gkostadinov/glimdock/README.md

# Glimdock

Glimdock brings servers, routers, appliances and printers to one small touchscreen. A **host-agnostic Rust collector** owns the node registry, accepts device readings and serves the management web interface. The display pairs with that collector once; registered nodes then appear automatically in its **All systems** bento overview.

Linux, macOS and Windows machines use native Rust agents that push telemetry to the collector. Agents pair once, receive a stable node identity and need no incoming network connection. Routers and other appliances can expose read-only SNMP or a JSON API through the same Rust device agent. Proxmox adds guest, storage and GPU features to a node; Klipper adds print job and temperature views. Neither integration is required to run the collector.

```text
Linux / macOS / Windows agents ──push──┐
SNMP / JSON adapters ────────────push──┤   Moonraker / legacy feeds
                                     │          ↑ polling
                   Rust collector: node registry + web console
                           /                         \
              Glimdock ESP32-S3                Desktop browser
              All systems + details       Overview · Nodes · Display & firmware
```

## Start with the collector

Run the matching Linux or macOS executable with a private state directory:

```sh
glimdock-collector run --state-dir ./glimdock-state --bind 127.0.0.1 --port 8765
```

Open `http://127.0.0.1:8765/`. The same server collects telemetry, applies node edits and serves the interface; no separate web server is needed. Local access works directly. Fresh configurations monitor the collector's native host as an ordinary **Server / device** node. You can pause or remove that node and use the collector only to receive agent pushes and aggregate optional polling feeds.

Use [SETUP.md](SETUP.md) for credentials, LAN access, display pairing and persistent services. [DEVICES.md](public-docs/DEVICES.md) explains how to pair an agent or adapter with a one-time key. Enrollment assigns a stable node ID automatically; changing a name preserves it. Explicit `--re-enroll` renews a revoked publisher with a fresh key while retaining device and node identity. Polling remains available for printers and existing APIs. Devices enroll explicitly; network scanning and credential discovery are not required.

## One interface for the fleet and display

The collector's built-in web console has three views:

| View | What it does |
| --- | --- |
| **Overview** | Live summary cards for every active node, including available CPU, memory, temperature and printer readings |
| **Nodes** | Pair agents; rename, pause, revoke and remove nodes; add polling feeds and manage the optional collector host |
| **Display & firmware** | Run the actual LVGL firmware UI in the browser and update the supported display over USB |

The browser firmware is compiled from the production UI, fonts, parsers and touch behavior into WebAssembly. It shares the display's layout and interactions; browser transport replaces the board peripherals. The larger web overview is a separate interface for managing the fleet.

White/dark themes, a clock view, short notification banners and saved speaker volume make the desk display usable between checks. An optional supported LiPo uses approximate voltage/bands and one warning per confirmed low-voltage episode; it does not report a charge percentage. [Firmware settings](firmware/README.md) document the evidence and limits.

The physical display starts on **All systems**, with up to four summary cards. Tap a card to open its dashboard. Ordinary devices have Overview, Storage, Sensors and Health; Proxmox adds guest views; Klipper has Overview, Job, Temps and Health. Unavailable or expired measurements remain unknown. Up to sixteen remote nodes can be configured, with four active top-level nodes including the optional collector host and eight active nodes in total. Managed switches and other appliances can be grouped beneath a parent node with `parent_id`; each keeps its own readings and freshness.

## Browser firmware updates

Connect a **Waveshare ESP32-S3-Touch-LCD-2.8 V1** Glimdock by USB, open **Display & firmware** in desktop Chrome or Edge, then choose **Connect & update**. Web Serial needs HTTPS or localhost. For a collector served over LAN HTTP, the Rust loopback companion serves the same console on the USB computer; [SETUP.md](SETUP.md) has the command.

The public update verifies the board and image hashes, preserves saved NVS pairing and preferences, and restarts the display. A new board opens setup. The update download includes version-matched source, dependency notices and practical rebuild/relink materials. V2/CST3530 is not supported by the V1 image.

## Private conversation review

Open **Settings → Private conversations** to read authorized user/assistant chats
on the physical display. Pair a separate HTTPS relay over USB using a dedicated,
revocable device credential and CA certificate. Conversations appear as scrolling
chat bubbles with session/message paging and long-message continuation. Private
text stays in a separate transient model and is cleared when you leave the reader.

The public browser demo uses fictional conversations only. Private pairing files,
reader keys and archive contents are excluded from public source and firmware.
See [private-reader setup and API](docs/private-conversations.md).

## Flipper Zero companion screen

An optional Bluetooth LE connection sends compact **System, Alerts, Agents and
Printer** pages to Flipper Zero. Install and open the
[Flipper app](integrations/flipper/README.md), then pair from
**Settings → Flipper Bluetooth screen** on Glimdock. Sharing starts disabled and
requires the PIN shown by Flipper.

The app keeps summaries for up to eight active nodes and previously received
node details in RAM. **Up/Down** changes the displayed node immediately, including
while disconnected; Glimdock fetches the selected node's details in the
background. **Left/Right** switches pages, **OK** returns to System and **Back**
exits. Closing the app clears its cache. Source ages and LIVE, SUMMARY, CACHED,
LOADING, STALE, NO UPDATES, DISCONNECTED and DEMO labels keep freshness visible.

Pairing, six-node browsing, offline navigation, page changes and saved-pair
reconnection have been physically validated on the V1 board with Momentum
mntm-012. See [validation scope](public-docs/VALIDATION.md#flipper-zero-cache--17-october-2026)
for the measurements and tested configuration.

## Hardware and enclosure

The supported board has an ST7789 display, CST328 touch, 16 MiB flash and 8 MiB PSRAM. The current **[Portable r45 enclosure](enclosure/public/portable-r45/README.md)** is a removable sculpted pod with a matching rear shell, battery space, two speakers and separate passive landscape and portrait stands. The native USB opening is on the right in the supported 320 × 240 landscape layout, rotation 3.

The curated public package includes 23 print parts, editable STEP/BREP, an original-parts assembly, an interactive viewer and portable OrcaSlicer layouts. It contains the repaired front/tunnel pair, two carrier rails, compact spring button, closed-front stand and stronger accessories. Printer connections, vendor presets, G-code and development trials are excluded. Physical fit, print finish and battery configuration need their own checks. See [the current enclosure guide](public-docs/ENCLOSURE.md) for source and validation boundaries. The r26 snapshot and r19 parametric model remain historical references.

## Build and contribute

The [agent operations design and API](public-docs/AGENT-OPERATIONS.md) provides a
playable four-tab workspace and a framework-neutral, read-only telemetry
contract. [Integration examples](public-docs/AGENT-INTEGRATION.md) and
[agent-ready implementation prompts](public-docs/AGENT-PROMPTS.md) cover source
adapters, the Rust collector, firmware and release review. It can read shared coordination metadata or another system's JSON
snapshot. The Rust collector and ESP32 consume it in a native four-tab workspace. Use the Nodes / Agents control on the overview to switch workspaces. The original logo returns to the current workspace’s home screen: Agents in Agents mode, Nodes in Nodes mode.

The Rust workspace contains `collector-rs/` and `device-agent-rs/`. Build both executables with:

```sh
cargo build --workspace --locked --release
cargo test --workspace --locked
```

The executables are `target/release/glimdock-collector` and `target/release/glimdock-agent` (`.exe` for a Windows agent). The collector embeds `collector-web/`, the firmware WebAssembly renderer and the public USB update bundle. Build browser assets before compiling a distributable collector; [BUILDING.md](public-docs/BUILDING.md) gives the complete order and verification commands.

| Path | Purpose |
| --- | --- |
| `collector-rs/` | Rust central collector, node configuration and authenticated HTTP APIs |
| `device-agent-rs/` | Native Rust push agents, host telemetry, SNMP and mapped JSON adapters |
| `collector-web/` | Built-in management console, browser firmware and USB updater |
| `firmware/` | Production LVGL touchscreen firmware |
| `examples/` | Generic collector, node, agent and synthetic snapshot examples |
| `deploy/` | Linux service installation and compatibility wrappers |
| `integrations/truenas/` | Optional restricted NAS compatibility helper |
| `tools/native-preview/`, `tools/web-emulator/` | Shared firmware rendering and behavioral verification |
| `enclosure/public/portable-r45/` | Current editable enclosure CAD, print parts, portable layouts and viewer |
| `commercial/site/` | Product website |
| `legacy/python/` | Archived Python collector and former design preview |

Deployed collectors, the web server and device agents use Rust. Python, Node.js, CMake and PlatformIO support builds, rendering and validation; the optional NAS/QGA compatibility probes run on their monitored systems. See [native telemetry](collector-rs/docs/TELEMETRY.md) for measurement semantics and optional tool requirements.

Original software, documentation and graphics are MIT licensed; original enclosure designs use CERN-OHL-P-2.0. Dependencies retain their own licenses. See [LICENSE_POLICY.md](LICENSE_POLICY.md), [THIRD_PARTY_NOTICES.md](THIRD_PARTY_NOTICES.md), [contributing](public-docs/CONTRIBUTING.md) and [security](public-docs/SECURITY.md). Historical validation and prototype observations remain in [docs/validation.md](docs/validation.md).
