gkostadinov/glimdock/public-docs/README.md

# Glimdock documentation

The current introduction and repository map are in [the root README](../README.md).
Start with [SETUP.md](../SETUP.md) to run the central collector, pair native push agents and
pair or update the display.

| Guide | Scope |
| --- | --- |
| [Setup](../SETUP.md) | Linux/macOS collector, built-in console, keys, node management and Chrome USB updates |
| [macOS RAM](../docs/macos-memory.md) | Native pressure, compression, cache, swap and Proxmox guest mapping |
| [Devices](DEVICES.md) | Native push enrollment, Linux/macOS/Windows agents, SNMP routers, JSON APIs and polling migration |
| [Building](BUILDING.md) | Rust workspace, web assets, public firmware and verification |
| [Architecture](../docs/architecture.md) | Registry, runtime boundaries, telemetry and management contracts |
| [Firmware](../firmware/README.md) | Supported board, pairing, orientations and display behavior |
| [Flipper Zero](../integrations/flipper/README.md) | Paired Bluetooth pages, local node cache, buttons, build and installation |
| [Pebble Landscape](../enclosure/pebble-landscape/README.md) | Current enclosure concept and assembly status |
| [Contributing](CONTRIBUTING.md) | Development expectations |
| [Security](SECURITY.md) | Credentials and vulnerability reporting |

Original software and documentation use [MIT](../LICENSE); original enclosure
geometry uses CERN-OHL-P-2.0. [License scope](../LICENSE_POLICY.md) and
[third-party notices](../THIRD_PARTY_NOTICES.md) cover the separate dependencies.
