gkostadinov/glimdock/enclosure/pebble-landscape/README.md

# Historical r19 enclosure source

This folder preserves the earlier parametric model. Current fitted CAD and validation caveats are in [the Pebble public prototype](../public/pebble-r26-prototype-v2/README.md) and [the enclosure guide](../../public-docs/ENCLOSURE.md). Do not treat this historical model as the current assembled product.
