gkostadinov/glimdock/commercial/site/scripts/product-artwork/synthetic-screen-portrait.png

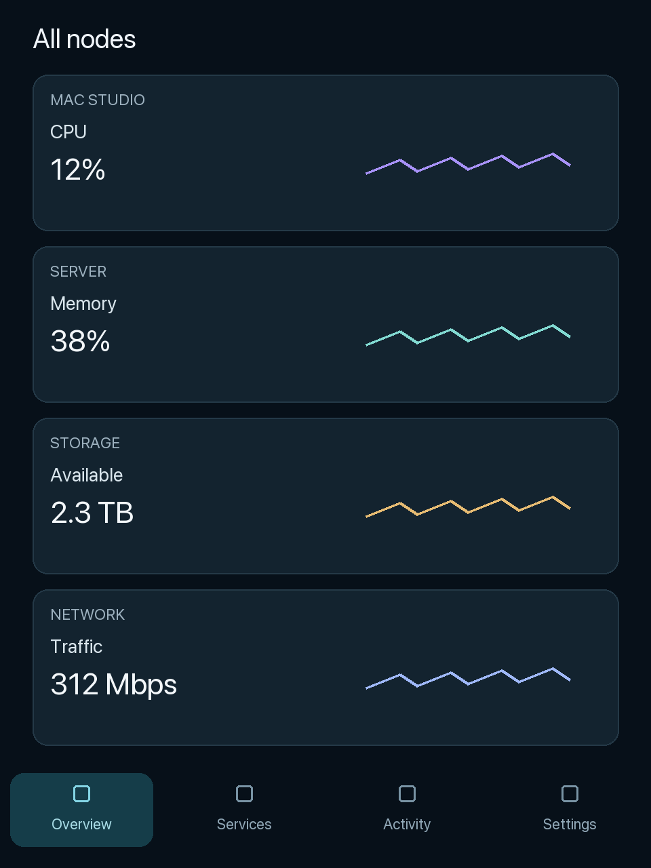
commercial/site/scripts/product-artwork/synthetic-screen-portrait.png
