gkostadinov/glimdock/commercial/site/scripts/product-artwork/synthetic-screen.png

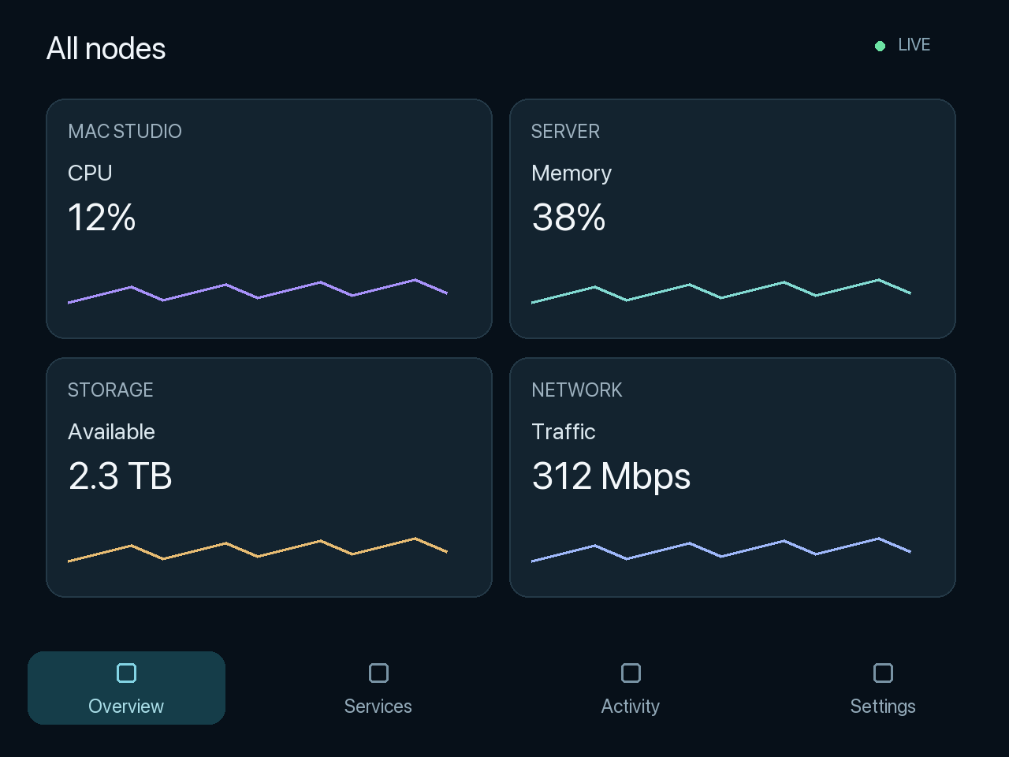
commercial/site/scripts/product-artwork/synthetic-screen.png
