gkostadinov/glimdock/enclosure/public/pebble-r26-prototype-v2/cad/pebble-own-parts-assembly.step

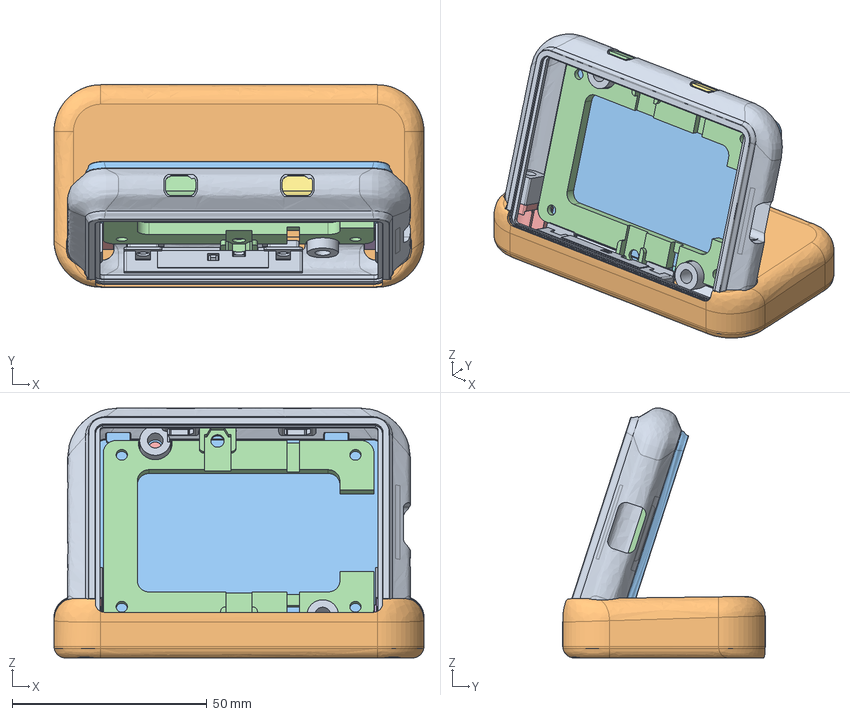
[picture p4: CAD file, 2026-10-13]
enclosure/public/pebble-r26-prototype-v2/cad/pebble-own-parts-assembly.step
95.0 x 52.0 x 64.2 mm
purple-body
white-cradle-500
rear-cover
display-carrier
saddle-left
saddle-right
battery-hatch-500
battery-tray-500
power-follower
power-input
input-window-cover-left
accessory-blank-cap-left
rear-screw-cap-left
input-window-cover-right
accessory-blank-cap-right
rear-screw-cap-right
