gkostadinov/glimdock/enclosure/public/portable-r45/cad/portable-r45-landscape-assembly.step

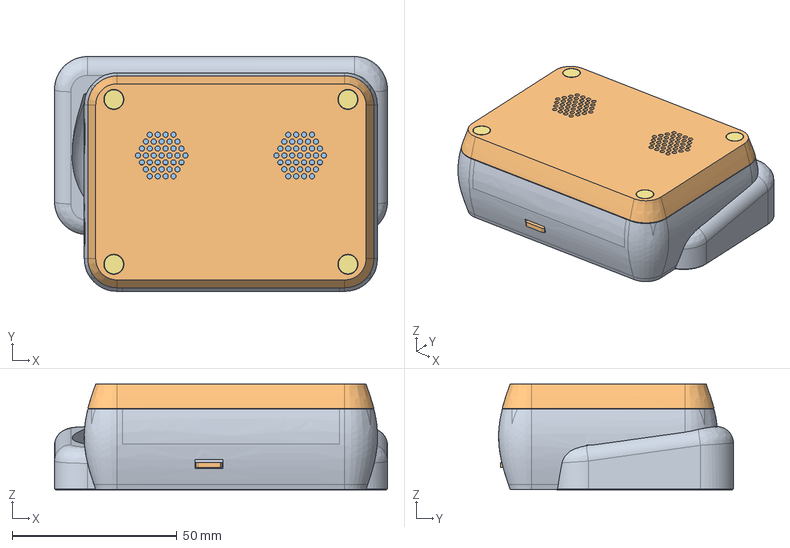
[picture p5: CAD file, 2026-10-30]
enclosure/public/portable-r45/cad/portable-r45-landscape-assembly.step
101.0 x 71.2 x 32.2 mm
