gkostadinov/glimdock/enclosure/public/pebble-r26-prototype-v2/cad/battery-hatch-500.step

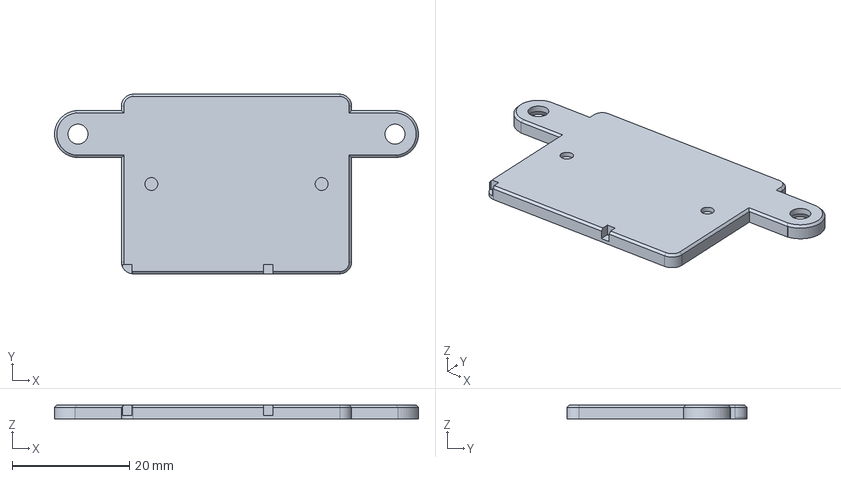
[picture p6: CAD file, 2026-10-13]
enclosure/public/pebble-r26-prototype-v2/cad/battery-hatch-500.step
62.0 x 30.6 x 2.40 mm
