gkostadinov/glimdock/enclosure/public/portable-r45/assembly/landscape-stand.stl

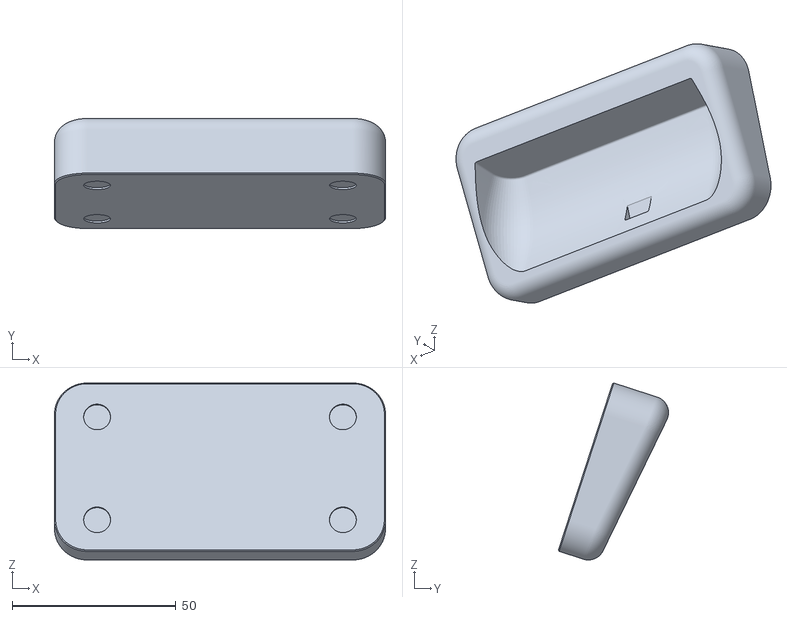
[picture p7: CAD file, 2026-10-30]
enclosure/public/portable-r45/assembly/landscape-stand.stl
101.0 x 33.6 x 54.0
