gkostadinov/glimdock/enclosure/public/portable-r45/cad/bunny-ear-right.step

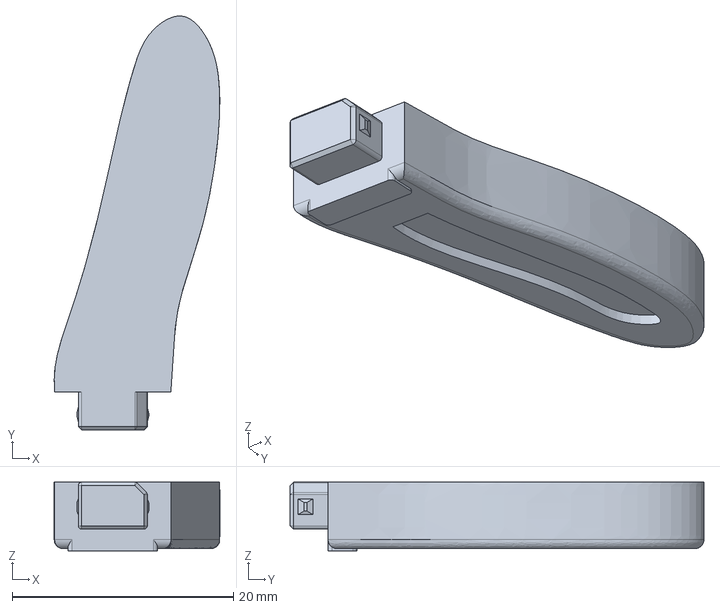
[picture p8: CAD file, 2026-10-30]
enclosure/public/portable-r45/cad/bunny-ear-right.step
15.0 x 37.4 x 6.20 mm
