gkostadinov/glimdock/enclosure/public/portable-r45/print-projects/portable-r45-portrait-stand-layout.3mf

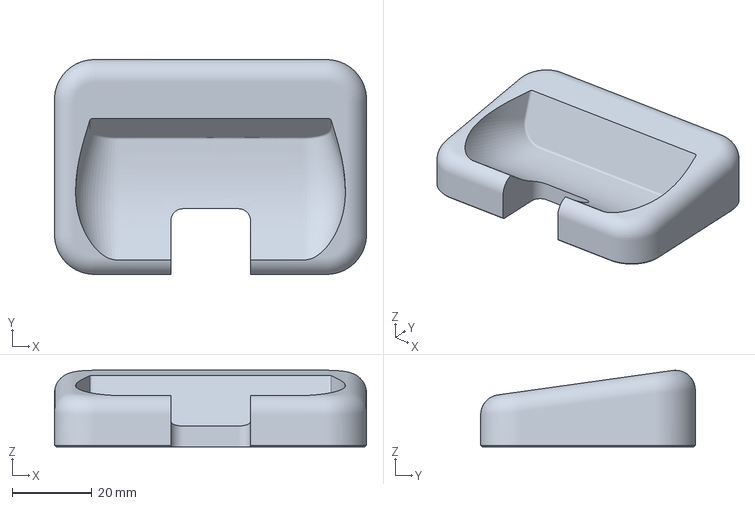
[picture p9: CAD file, 2026-10-30]
enclosure/public/portable-r45/print-projects/portable-r45-portrait-stand-layout.3mf
78.5 x 54.0 x 19.3 mm
