gkostadinov/glimdock/enclosure/public/portable-r45/viewer/reference/battery-envelope.stl

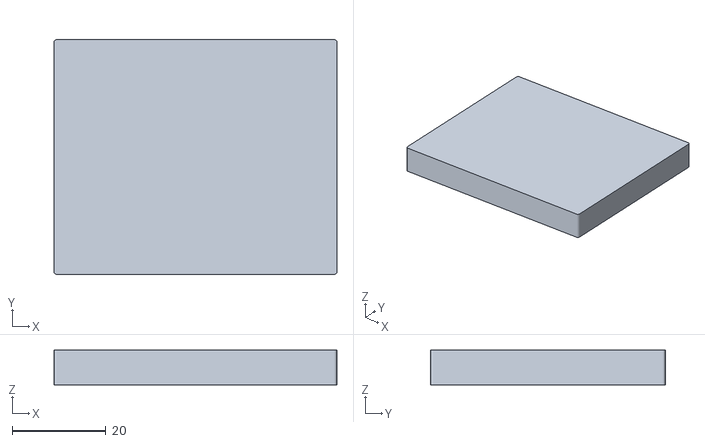
[picture p10: CAD file, 2026-10-30]
enclosure/public/portable-r45/viewer/reference/battery-envelope.stl
60.5 x 50.2 x 7.40
