gkostadinov/glimdock/enclosure/public/pebble-r26-prototype-v2/cad/input-window-cover-left.step

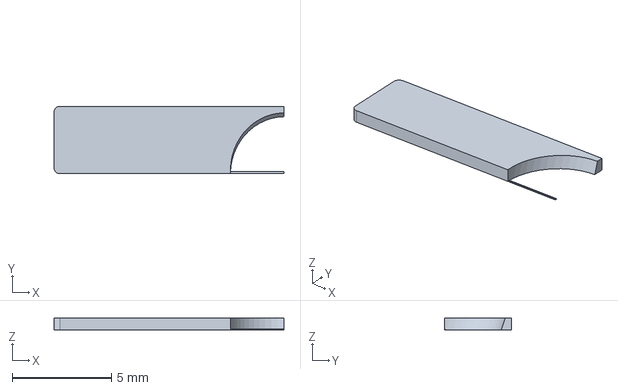
[picture p11: CAD file, 2026-10-13]
enclosure/public/pebble-r26-prototype-v2/cad/input-window-cover-left.step
11.6 x 3.40 x 0.6 mm
