gkostadinov/glimdock/enclosure/public/portable-r45/assembly/button-compact.stl

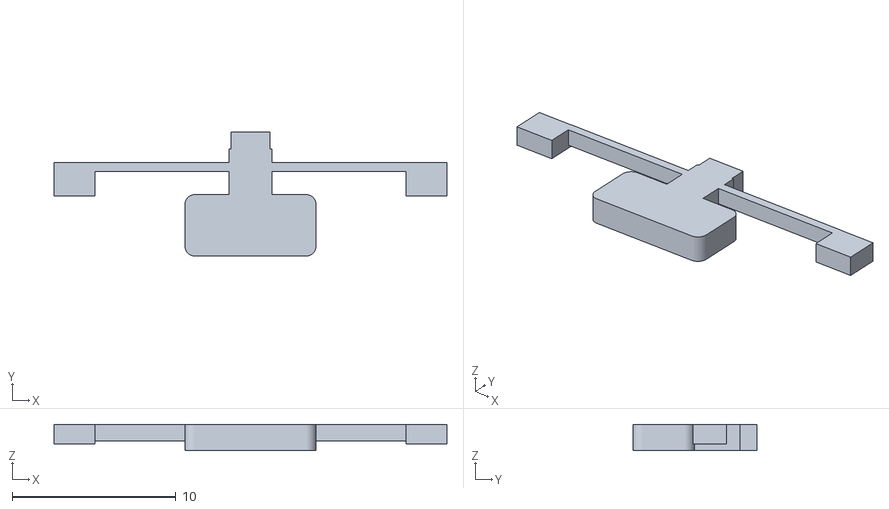
[picture p12: CAD file, 2026-10-30]
enclosure/public/portable-r45/assembly/button-compact.stl
24.0 x 7.57 x 1.60
