gkostadinov/glimdock/enclosure/public/portable-r45/cad/tv-antenna-right.step

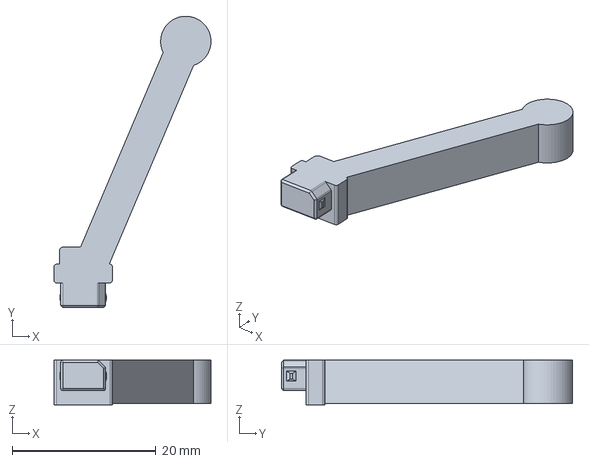
[picture p13: CAD file, 2026-10-30]
enclosure/public/portable-r45/cad/tv-antenna-right.step
21.8 x 40.5 x 6.20 mm
