gkostadinov/glimdock/enclosure/public/portable-r45/viewer/reference/display-envelope.stl

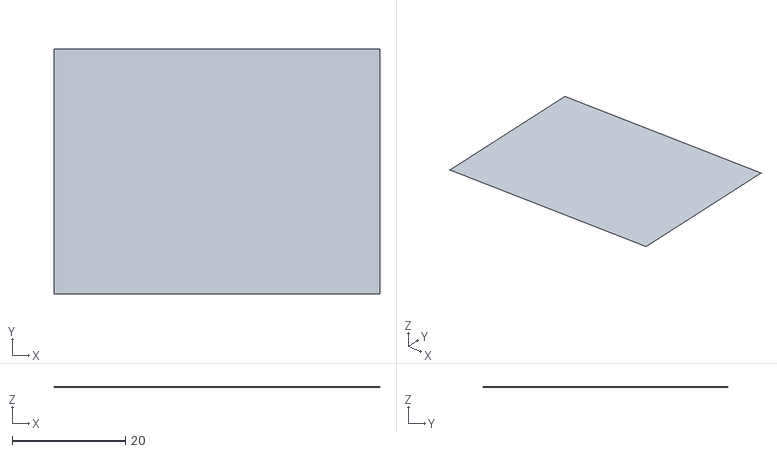
[picture p14: CAD file, 2026-10-30]
enclosure/public/portable-r45/viewer/reference/display-envelope.stl
57.6 x 43.2 x 0.01
