gkostadinov/glimdock/enclosure/public/pebble-r26-prototype-v2/cad/eye-accent-left.step

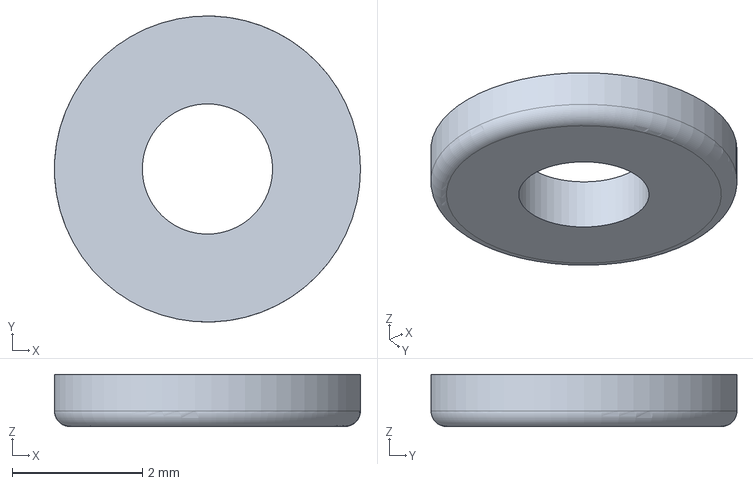
[picture p15: CAD file, 2026-10-13]
enclosure/public/pebble-r26-prototype-v2/cad/eye-accent-left.step
4.70 x 4.70 x 0.8 mm
