gkostadinov/glimdock/enclosure/public/portable-r45/assembly/battery-tray.stl

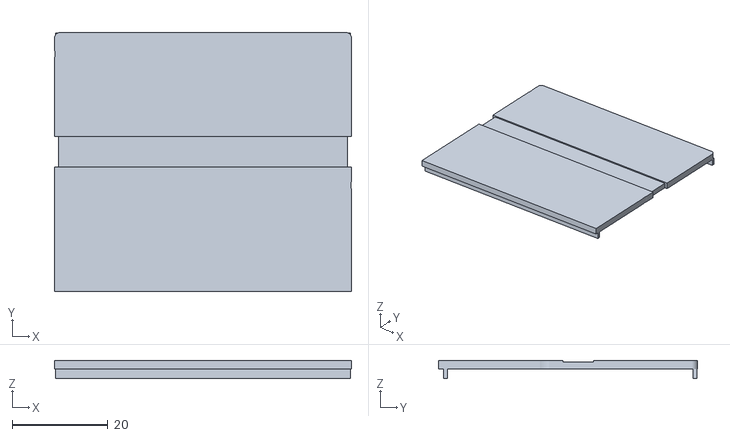
[picture p16: CAD file, 2026-10-30]
enclosure/public/portable-r45/assembly/battery-tray.stl
62.2 x 54.2 x 3.80
