gkostadinov/glimdock/enclosure/public/portable-r45/print-projects/portable-r45-front-and-usb-tunnel.3mf

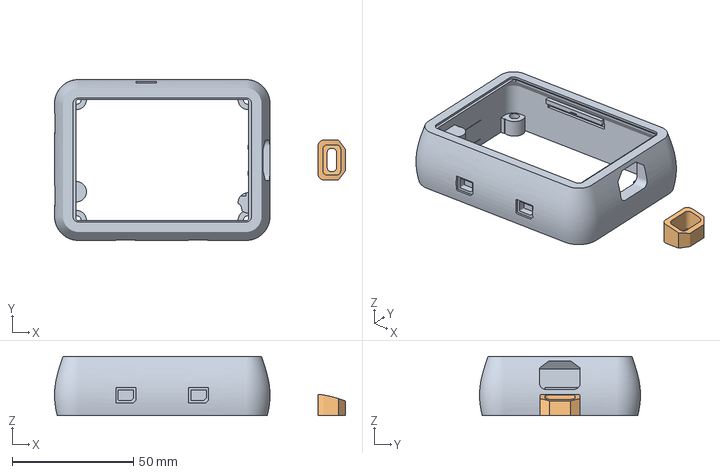
[picture p17: CAD file, 2026-10-30]
enclosure/public/portable-r45/print-projects/portable-r45-front-and-usb-tunnel.3mf
120.2 x 66.5 x 24.4 mm
purple-body.stl
usb-tunnel.stl
