gkostadinov/glimdock/enclosure/public/portable-r45/viewer/reference/speaker-left-envelope.stl

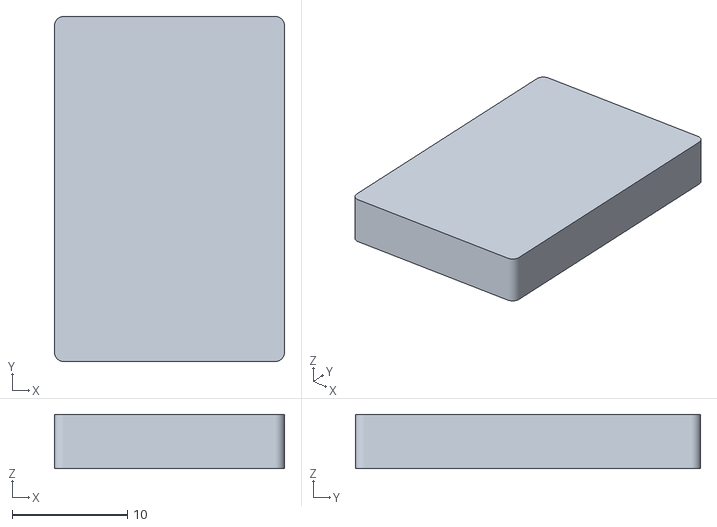
[picture p18: CAD file, 2026-10-30]
enclosure/public/portable-r45/viewer/reference/speaker-left-envelope.stl
20.0 x 30.0 x 4.70
