gkostadinov/glimdock/enclosure/public/portable-r45/assembly/usb-tunnel.stl

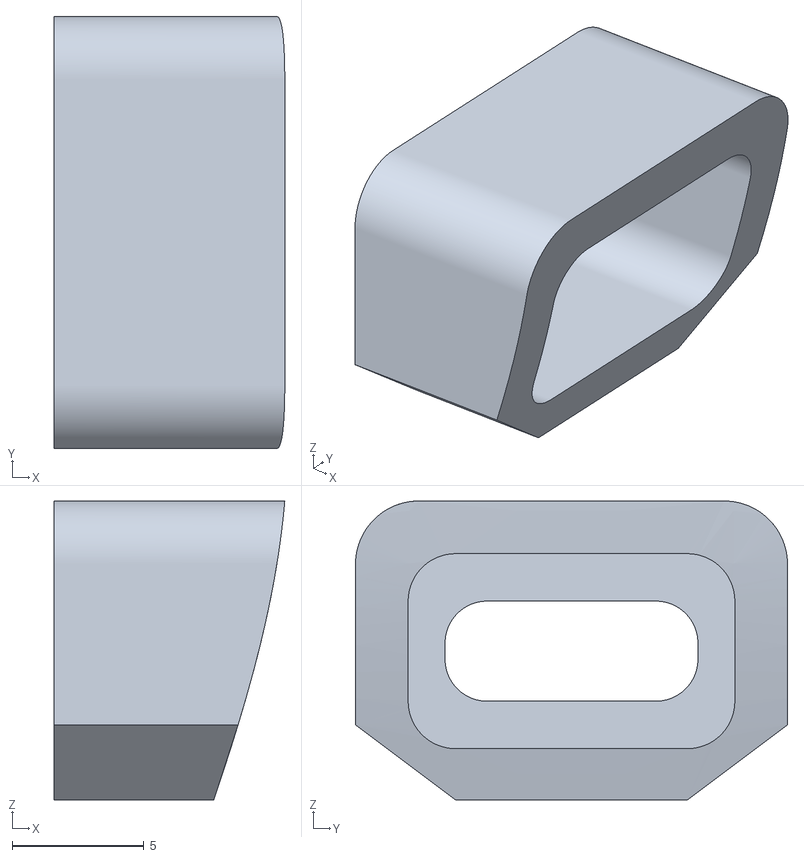
[picture p19: CAD file, 2026-10-30]
enclosure/public/portable-r45/assembly/usb-tunnel.stl
8.75 x 16.4 x 11.4
