gkostadinov/glimdock/enclosure/public/portable-r45/cad/display-carrier-right.step

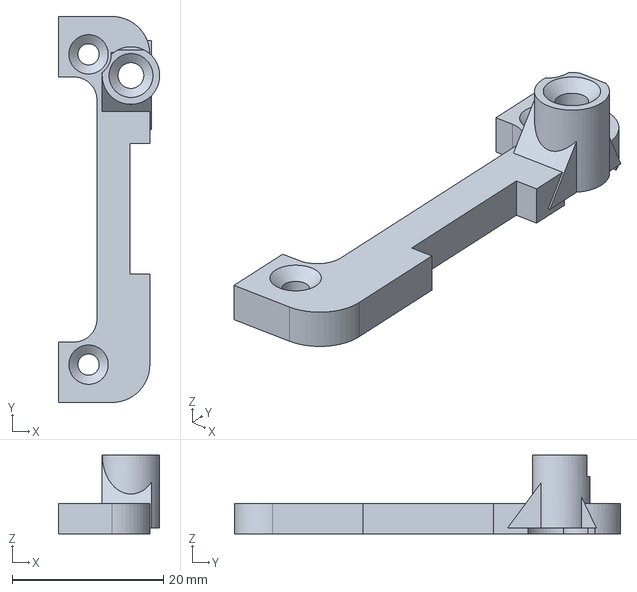
[picture p20: CAD file, 2026-10-30]
enclosure/public/portable-r45/cad/display-carrier-right.step
13.4 x 51.0 x 10.4 mm
