gkostadinov/glimdock/enclosure/public/portable-r45/print-projects/portable-r45-rear-cover.3mf

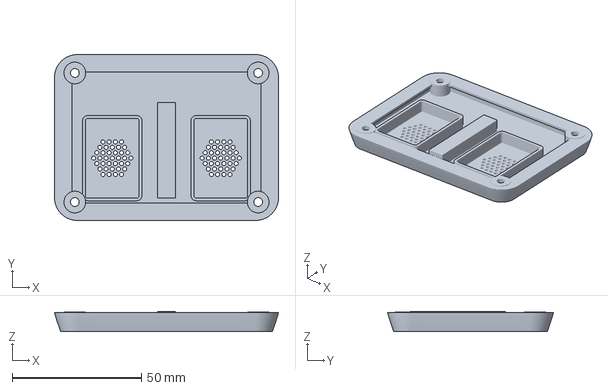
[picture p21: CAD file, 2026-10-30]
enclosure/public/portable-r45/print-projects/portable-r45-rear-cover.3mf
86.8 x 64.2 x 7.85 mm
