gkostadinov/glimdock/enclosure/public/pebble-r26-prototype-v2/cad/saddle-left.step

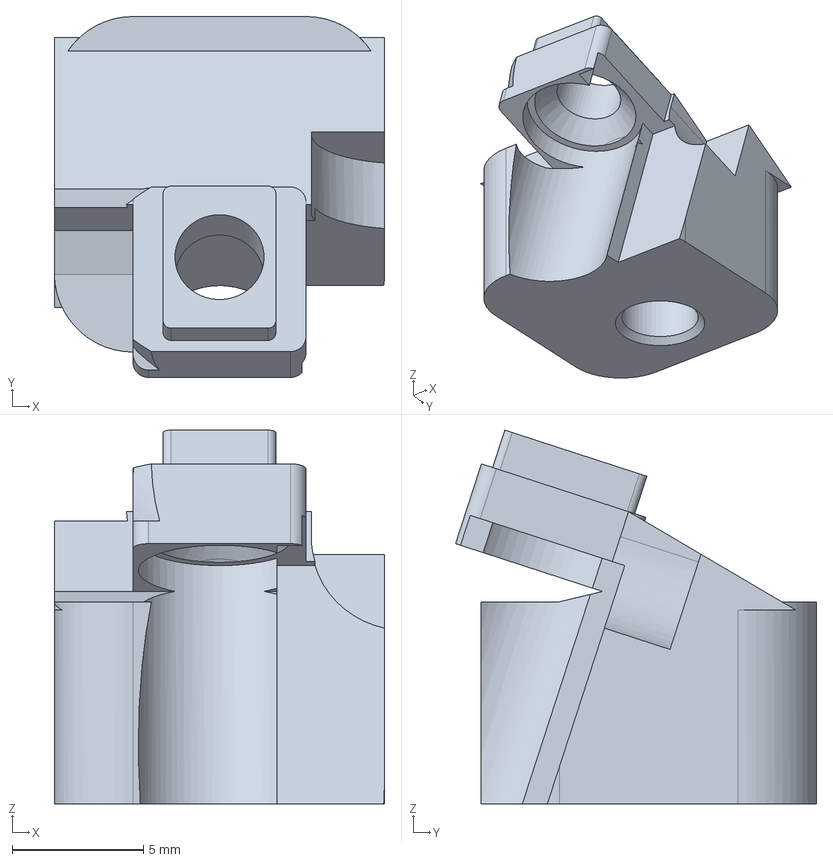
[picture p22: CAD file, 2026-10-13]
enclosure/public/pebble-r26-prototype-v2/cad/saddle-left.step
12.6 x 13.8 x 14.3 mm
