gkostadinov/glimdock/enclosure/public/portable-r45/cad/display-carrier-left.step

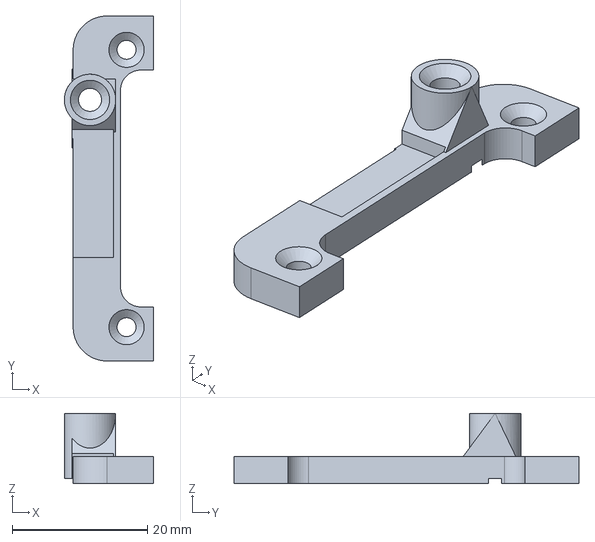
[picture p23: CAD file, 2026-10-30]
enclosure/public/portable-r45/cad/display-carrier-left.step
13.2 x 51.0 x 10.4 mm
