gkostadinov/glimdock/enclosure/public/portable-r45/print-projects/portable-r45-display-carrier-rails.3mf

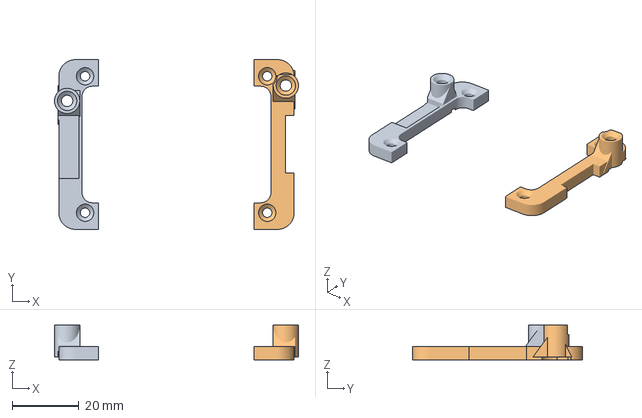
[picture p24: CAD file, 2026-10-30]
enclosure/public/portable-r45/print-projects/portable-r45-display-carrier-rails.3mf
73.3 x 51.0 x 10.4 mm
display-carrier-left.stl
display-carrier-right.stl
