gkostadinov/glimdock/enclosure/public/portable-r45/viewer/reference/glass-envelope.stl

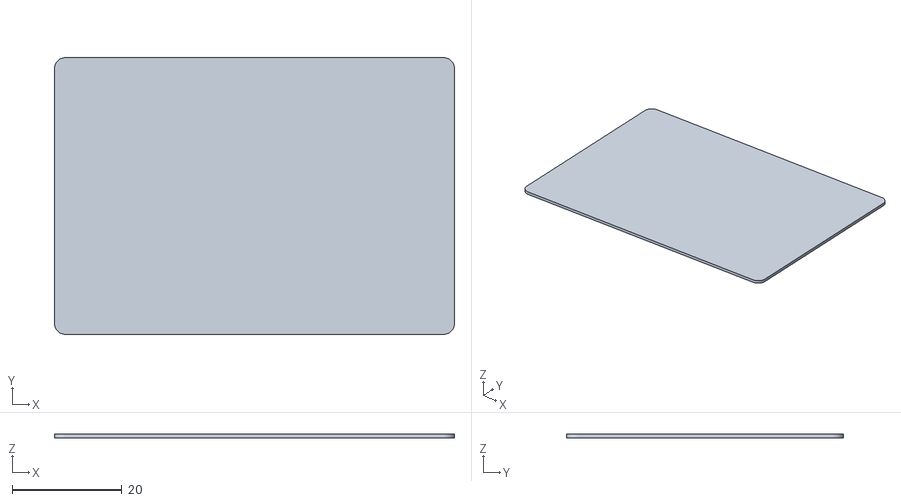
[picture p25: CAD file, 2026-10-30]
enclosure/public/portable-r45/viewer/reference/glass-envelope.stl
73.1 x 50.5 x 0.7
