gkostadinov/glimdock/enclosure/public/pebble-r26-prototype-v2/cad/bunny-ear-accent-right.step

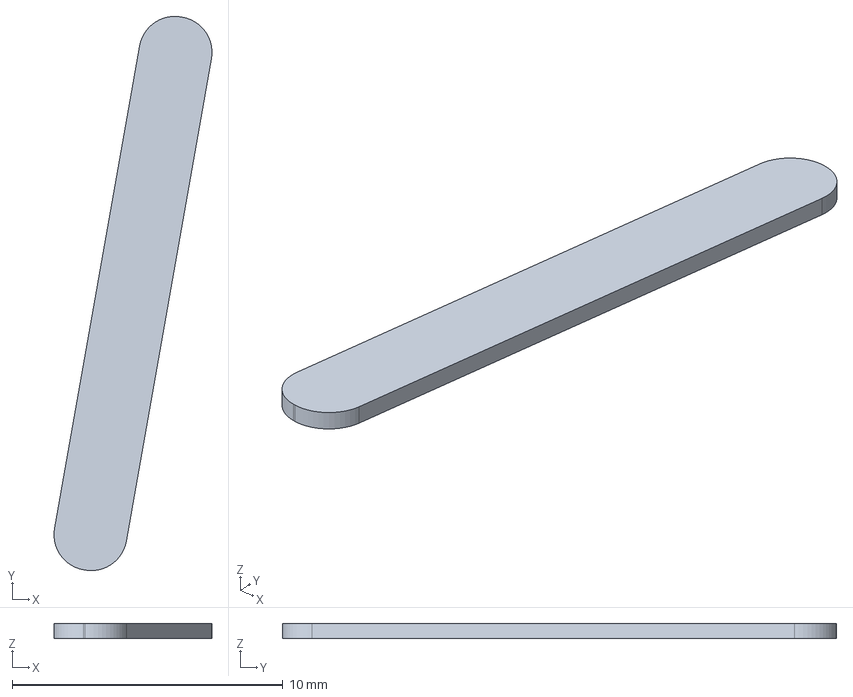
[picture p26: CAD file, 2026-10-13]
enclosure/public/pebble-r26-prototype-v2/cad/bunny-ear-accent-right.step
5.84 x 20.5 x 0.55 mm
