gkostadinov/glimdock/enclosure/public/portable-r45/assembly/accessory-cap-portrait-right.stl

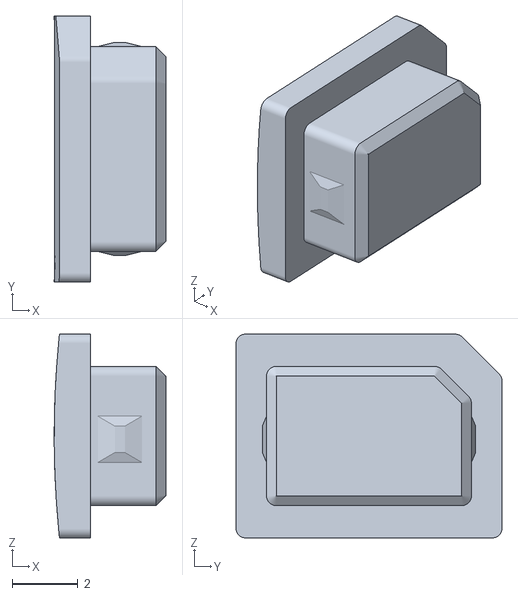
[picture p27: CAD file, 2026-10-30]
enclosure/public/portable-r45/assembly/accessory-cap-portrait-right.stl
3.40 x 8.10 x 6.20
