gkostadinov/glimdock/enclosure/public/portable-r45/cad/purple-body.step

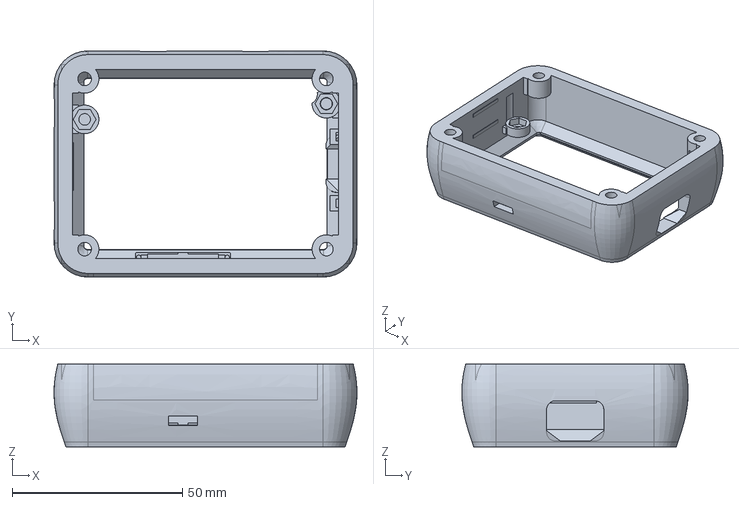
[picture p28: CAD file, 2026-10-30]
enclosure/public/portable-r45/cad/purple-body.step
89.0 x 66.5 x 24.4 mm
