gkostadinov/glimdock/enclosure/public/portable-r45/print-projects/portable-r45-rear-internals.3mf

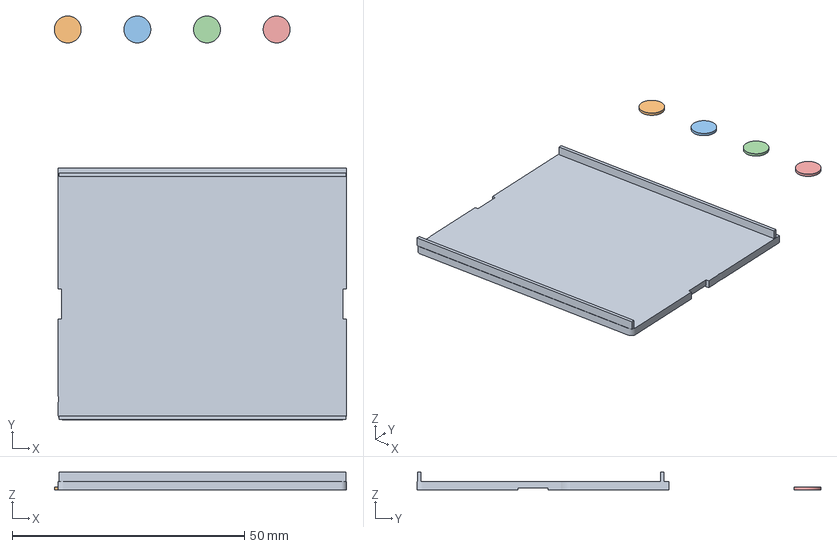
[picture p29: CAD file, 2026-10-30]
enclosure/public/portable-r45/print-projects/portable-r45-rear-internals.3mf
63.0 x 87.0 x 3.80 mm
battery-tray.stl
rear-screw-cap-1.stl
rear-screw-cap-2.stl
rear-screw-cap-3.stl
rear-screw-cap-4.stl
