gkostadinov/glimdock/enclosure/public/pebble-r26-prototype-v2/cad/eye-right.step

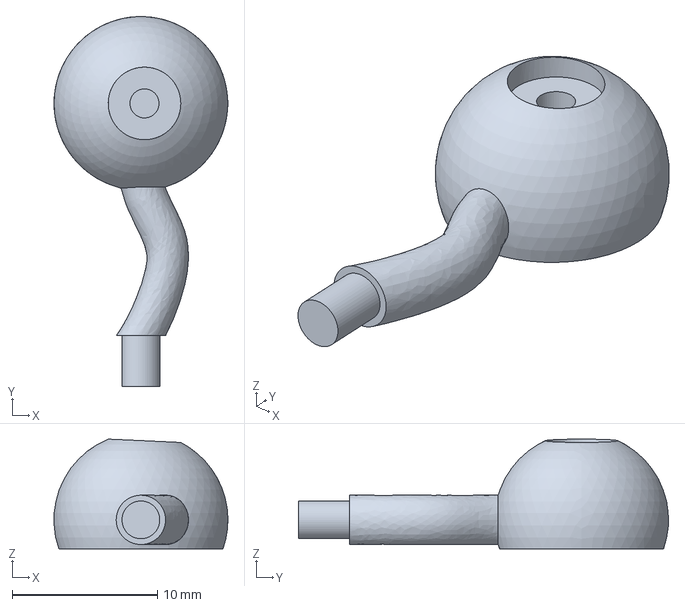
[picture p30: CAD file, 2026-10-13]
enclosure/public/pebble-r26-prototype-v2/cad/eye-right.step
12.0 x 25.5 x 7.56 mm
