gkostadinov/glimdock/enclosure/public/portable-r45/print-projects/portable-r45-landscape-stand.3mf

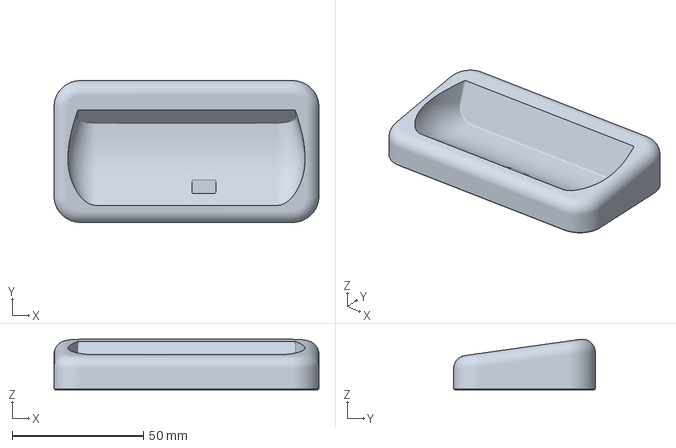
[picture p31: CAD file, 2026-10-30]
enclosure/public/portable-r45/print-projects/portable-r45-landscape-stand.3mf
101.0 x 54.0 x 19.3 mm
