gkostadinov/glimdock/enclosure/public/portable-r45/print-projects/portable-r45-accessories-and-plugs.3mf

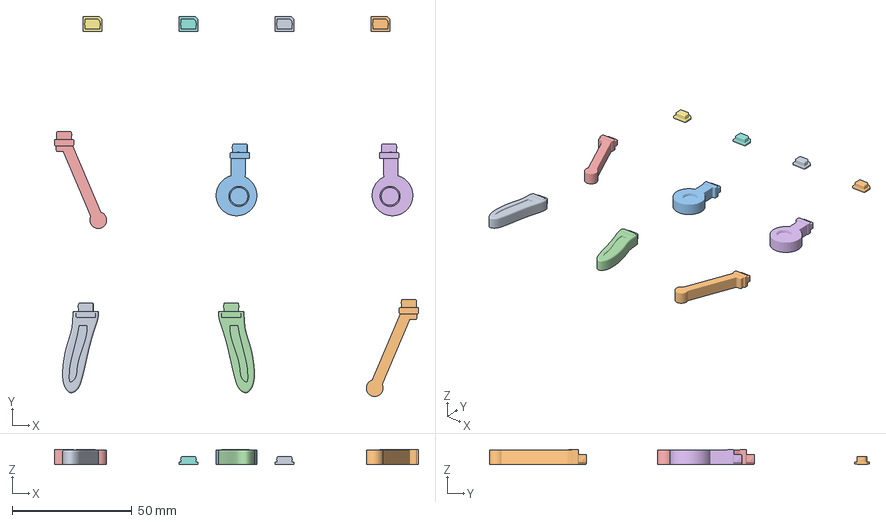
[picture p32: CAD file, 2026-10-30]
enclosure/public/portable-r45/print-projects/portable-r45-accessories-and-plugs.3mf
151.8 x 158.3 x 6.20 mm
bunny-ear-left.stl
tv-antenna-left.stl
eye-left.stl
bunny-ear-right.stl
tv-antenna-right.stl
eye-right.stl
accessory-cap-landscape-left.stl
accessory-cap-landscape-right.stl
accessory-cap-portrait-left.stl
accessory-cap-portrait-right.stl
