gkostadinov/glimdock/enclosure/public/pebble-r26-prototype-v2/cad/bunny-ear-right.step

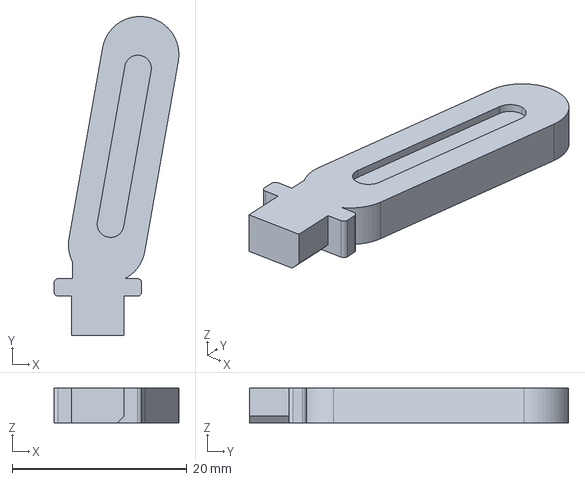
[picture p33: CAD file, 2026-10-13]
enclosure/public/pebble-r26-prototype-v2/cad/bunny-ear-right.step
14.3 x 36.5 x 4.00 mm
