gkostadinov/glimdock/enclosure/public/portable-r45/assembly/eye-right-portrait.stl

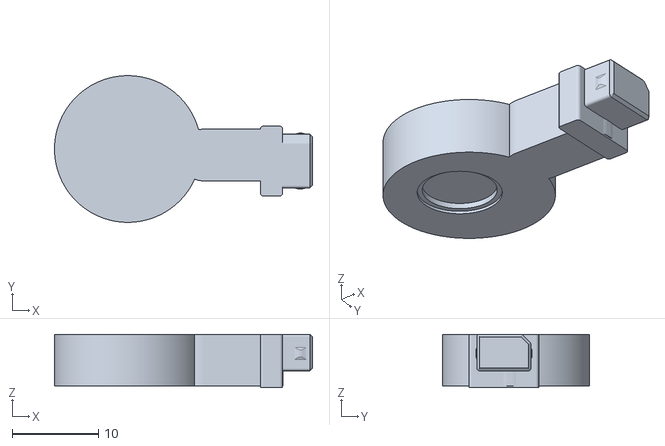
[picture p34: CAD file, 2026-10-30]
enclosure/public/portable-r45/assembly/eye-right-portrait.stl
29.9 x 17.0 x 6.20
