gkostadinov/glimdock/enclosure/public/pebble-r26-prototype-v2/cad/power-follower.step

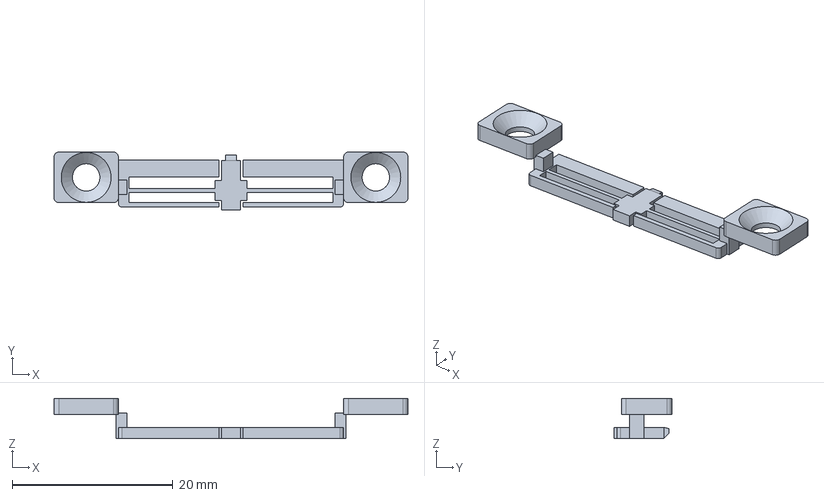
[picture p35: CAD file, 2026-10-13]
enclosure/public/pebble-r26-prototype-v2/cad/power-follower.step
44.0 x 7.20 x 5.00 mm
