gkostadinov/glimdock/enclosure/public/pebble-r26-prototype-v2/cad/accessory-collar-left.step

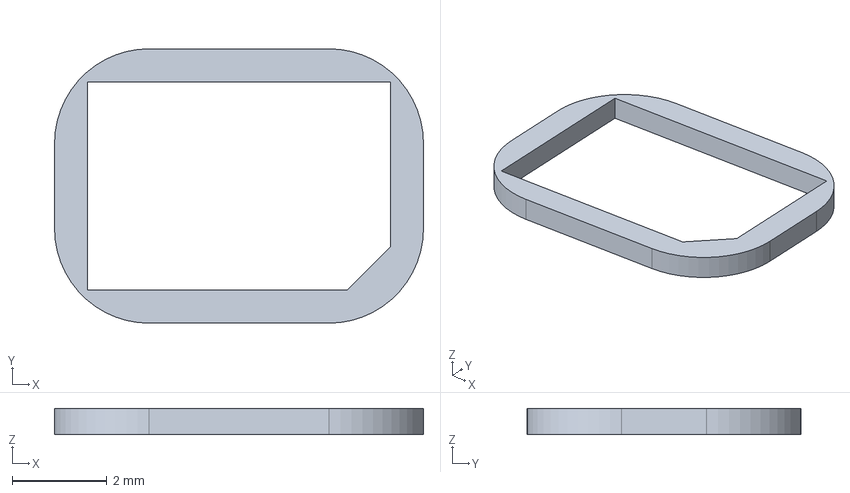
[picture p36: CAD file, 2026-10-13]
enclosure/public/pebble-r26-prototype-v2/cad/accessory-collar-left.step
7.80 x 5.80 x 0.55 mm
