gkostadinov/glimdock/enclosure/public/pebble-r26-prototype-v2/cad/tv-antenna-right.step

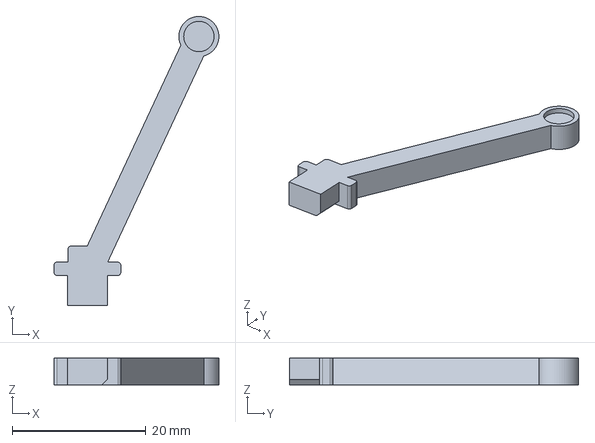
[picture p37: CAD file, 2026-10-13]
enclosure/public/pebble-r26-prototype-v2/cad/tv-antenna-right.step
24.7 x 43.3 x 4.00 mm
