gkostadinov/glimdock/enclosure/public/portable-r45/cad/purple-rear-cover.step

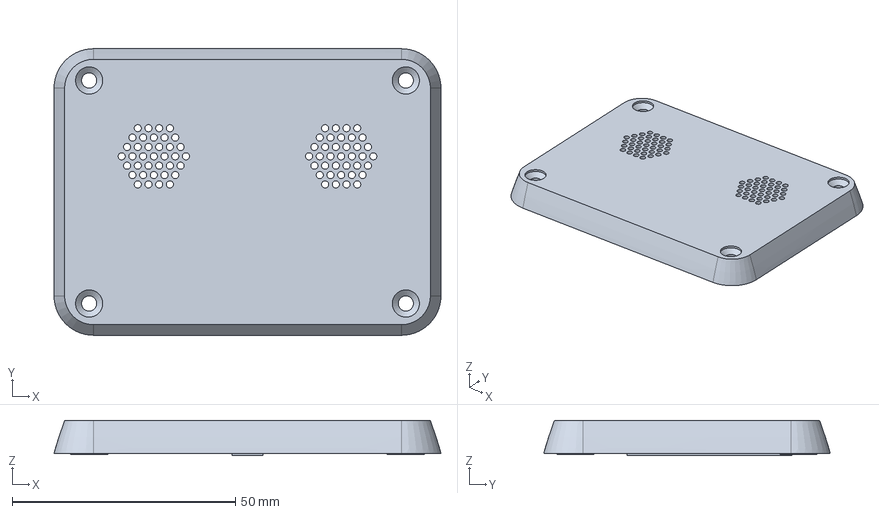
[picture p38: CAD file, 2026-10-30]
enclosure/public/portable-r45/cad/purple-rear-cover.step
86.8 x 64.2 x 7.85 mm
