gkostadinov/glimdock/enclosure/public/pebble-r26-prototype-v2/cad/eye-foot-left.step

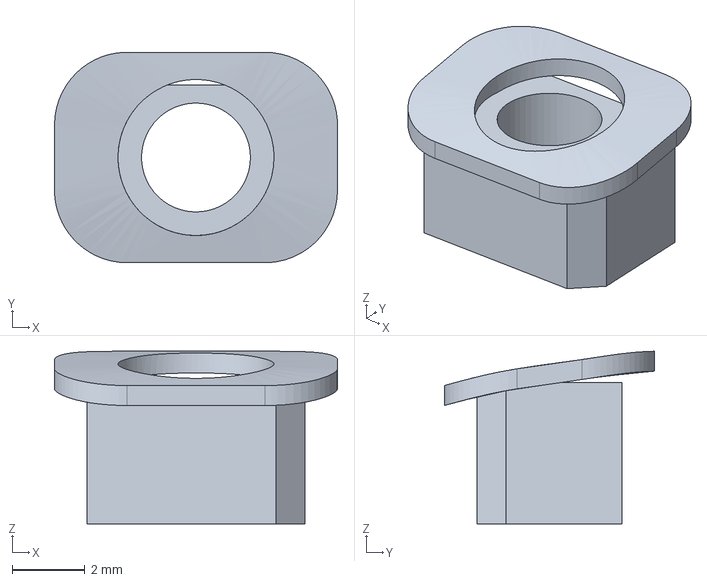
[picture p39: CAD file, 2026-10-13]
enclosure/public/pebble-r26-prototype-v2/cad/eye-foot-left.step
7.80 x 5.80 x 4.76 mm
