gkostadinov/glimdock/enclosure/public/pebble-r26-prototype-v2/cad/purple-body.step

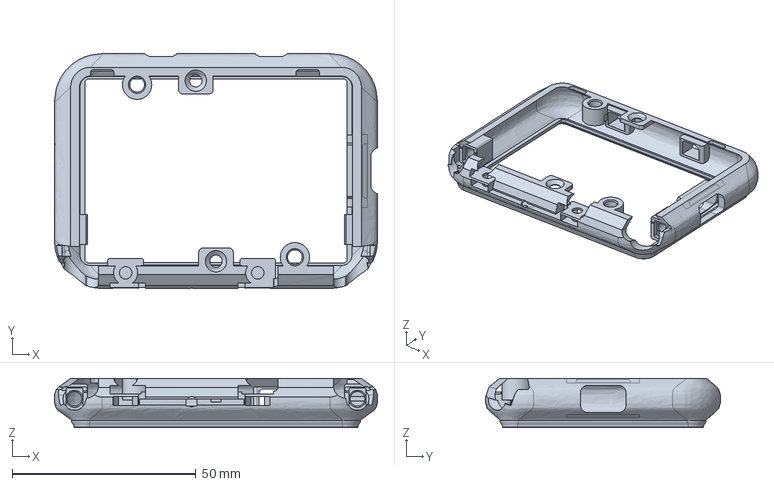
[picture p40: CAD file, 2026-10-13]
enclosure/public/pebble-r26-prototype-v2/cad/purple-body.step
88.0 x 64.0 x 13.4 mm
