gkostadinov/glimdock/enclosure/public/pebble-r26-prototype-v2/cad/accessory-fit-socket-strip.step

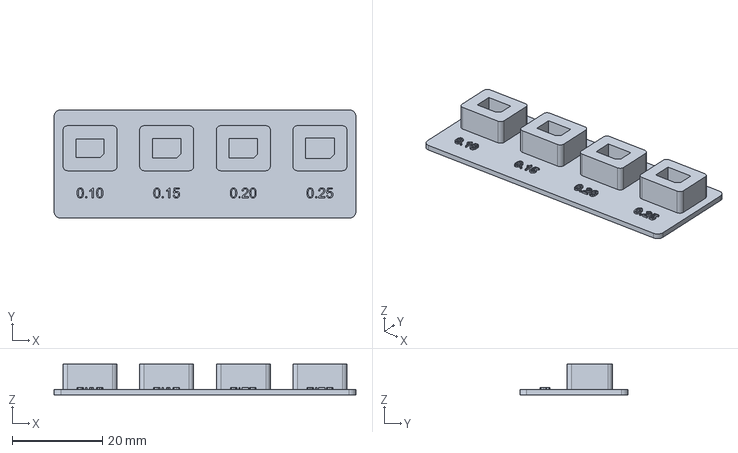
[picture p41: CAD file, 2026-10-13]
enclosure/public/pebble-r26-prototype-v2/cad/accessory-fit-socket-strip.step
67.0 x 24.0 x 6.80 mm
