gkostadinov/glimdock/enclosure/public/pebble-r26-prototype-v2/cad/battery-tray-500.step

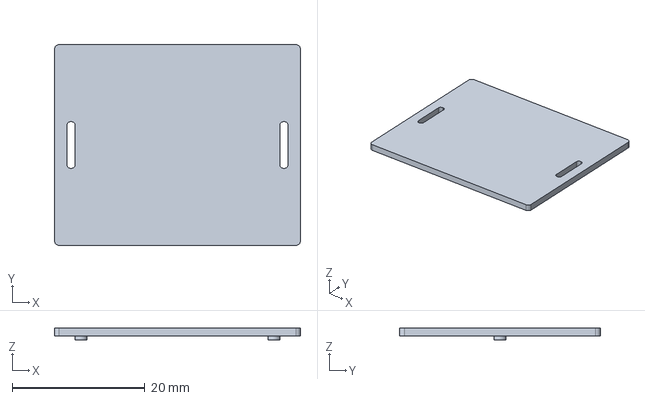
[picture p42: CAD file, 2026-10-13]
enclosure/public/pebble-r26-prototype-v2/cad/battery-tray-500.step
37.0 x 30.2 x 1.80 mm
