gkostadinov/glimdock/enclosure/public/pebble-r26-prototype-v2/cad/rear-cover.step

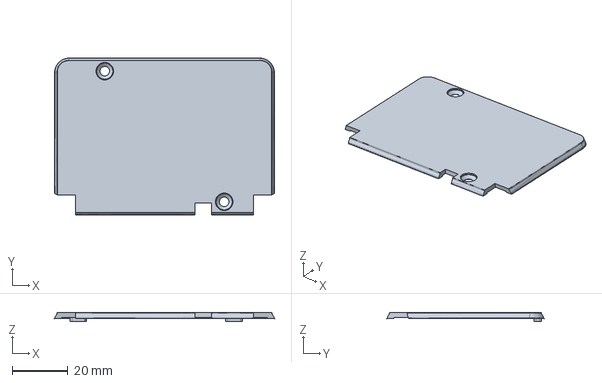
[picture p43: CAD file, 2026-10-13]
enclosure/public/pebble-r26-prototype-v2/cad/rear-cover.step
79.2 x 56.5 x 3.24 mm
