gkostadinov/glimdock/enclosure/public/pebble-r26-prototype-v2/cad/tv-antenna-accent-right.step

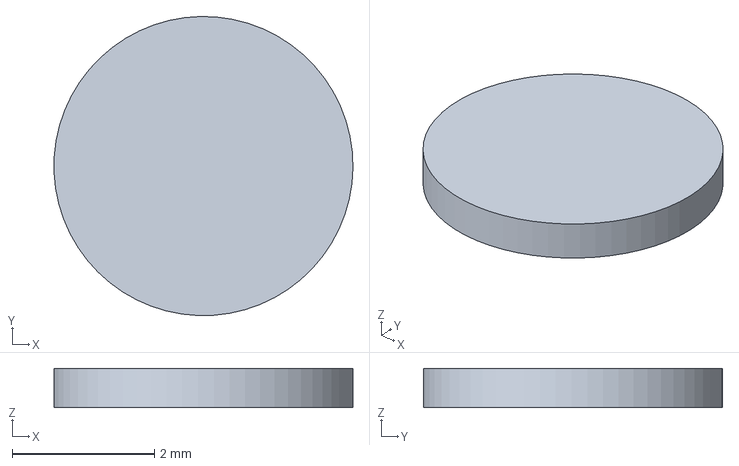
[picture p44: CAD file, 2026-10-13]
enclosure/public/pebble-r26-prototype-v2/cad/tv-antenna-accent-right.step
4.20 x 4.20 x 0.55 mm
