gkostadinov/glimdock/enclosure/public/pebble-r26-prototype-v2/cad/power-input.step

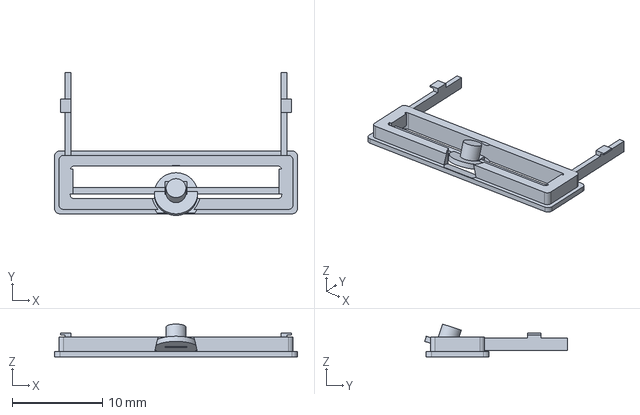
[picture p45: CAD file, 2026-10-13]
enclosure/public/pebble-r26-prototype-v2/cad/power-input.step
27.0 x 15.9 x 3.66 mm
