gkostadinov/glimdock/enclosure/public/pebble-r26-prototype-v2/cad/accessory-blank-cap-left.step

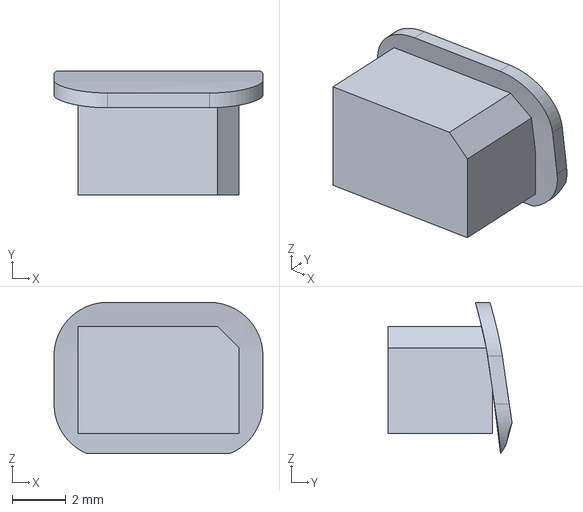
[picture p46: CAD file, 2026-10-13]
enclosure/public/pebble-r26-prototype-v2/cad/accessory-blank-cap-left.step
7.80 x 4.63 x 5.65 mm
