gkostadinov/glimdock/enclosure/public/pebble-r26-prototype-v2/cad/accessory-fit-test-pin.step

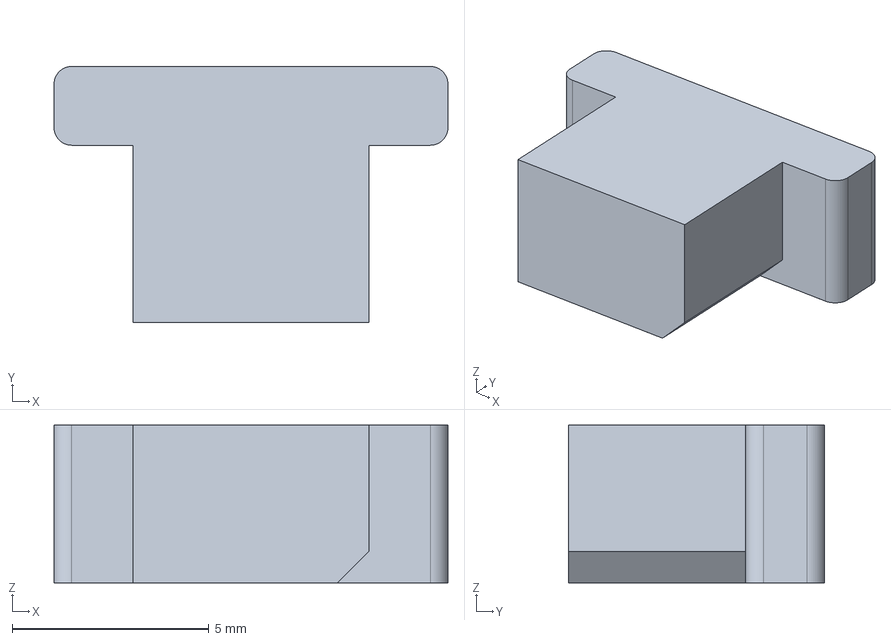
[picture p47: CAD file, 2026-10-13]
enclosure/public/pebble-r26-prototype-v2/cad/accessory-fit-test-pin.step
10.0 x 6.50 x 4.00 mm
