gkostadinov/glimdock/enclosure/public/pebble-r26-prototype-v2/cad/display-carrier.step

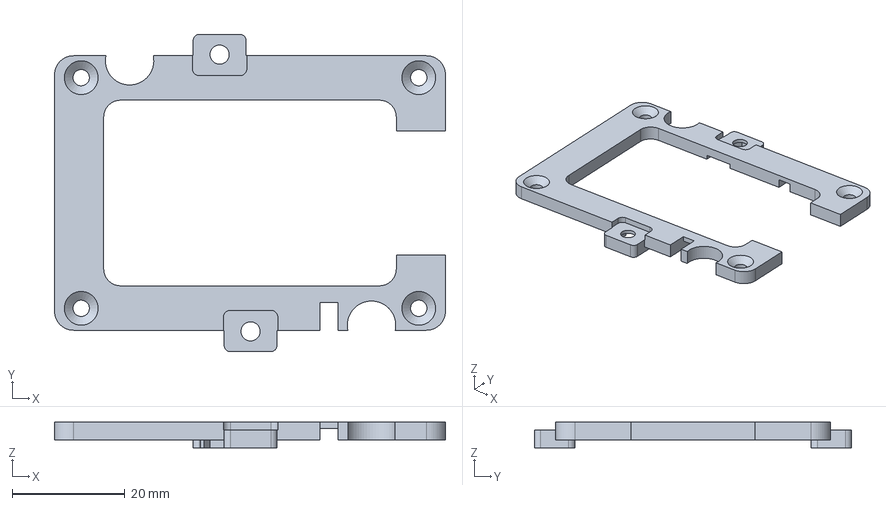
[picture p48: CAD file, 2026-10-13]
enclosure/public/pebble-r26-prototype-v2/cad/display-carrier.step
69.5 x 56.4 x 4.55 mm
