gkostadinov/glimdock/enclosure/public/pebble-r26-prototype-v2/cad/white-cradle-500.step

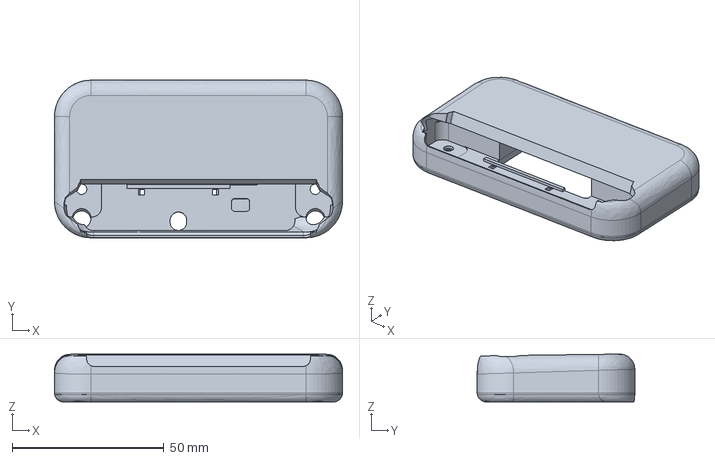
[picture p49: CAD file, 2026-10-13]
enclosure/public/pebble-r26-prototype-v2/cad/white-cradle-500.step
95.0 x 52.0 x 15.8 mm
