gkostadinov/glimdock/(list of files, cad)

Other CAD files:
enclosure/public/portable-r45/print-projects/portable-r45-power-button.3mf
enclosure/public/pebble-r26-prototype-v2/cad/eye-accent-right.step
enclosure/public/portable-r45/viewer/reference/speaker-right-envelope.stl
enclosure/public/portable-r45/assembly/tv-antenna-right.stl
enclosure/public/portable-r45/cad/button-compact.step
enclosure/public/portable-r45/assembly/tv-antenna-left.stl
enclosure/public/portable-r45/cad/usb-tunnel.step
enclosure/public/pebble-r26-prototype-v2/cad/bunny-ear-accent-left.step
enclosure/public/portable-r45/cad/eye-right.step
enclosure/public/portable-r45/assembly/tv-antenna-left-portrait.stl
enclosure/public/portable-r45/cad/eye-left.step
enclosure/public/portable-r45/assembly/tv-antenna-right-portrait.stl
enclosure/public/portable-r45/cad/tv-antenna-left.step
enclosure/public/pebble-r26-prototype-v2/cad/accessory-collar-right.step
enclosure/public/portable-r45/assembly/bunny-ear-left-portrait.stl
enclosure/public/portable-r45/cad/accessory-cap-landscape-left.step
enclosure/public/portable-r45/assembly/bunny-ear-right.stl
enclosure/public/portable-r45/assembly/eye-left-portrait.stl
enclosure/public/pebble-r26-prototype-v2/cad/bunny-ear-left.step
enclosure/public/portable-r45/cad/accessory-cap-portrait-left.step
enclosure/public/portable-r45/assembly/bunny-ear-left.stl
enclosure/public/portable-r45/cad/accessory-cap-landscape-right.step
enclosure/public/portable-r45/assembly/purple-body.stl
enclosure/public/portable-r45/cad/battery-tray.step
enclosure/public/portable-r45/assembly/accessory-cap-landscape-right.stl
enclosure/public/portable-r45/assembly/accessory-cap-landscape-left.stl
enclosure/public/portable-r45/cad/accessory-cap-portrait-right.step
enclosure/public/pebble-r26-prototype-v2/cad/input-window-cover-right.step
enclosure/public/portable-r45/assembly/purple-rear-cover.stl
enclosure/public/portable-r45/cad/landscape-stand.step
enclosure/public/portable-r45/assembly/display-carrier-right.stl
enclosure/public/portable-r45/cad/bunny-ear-left.step
enclosure/public/portable-r45/assembly/eye-right.stl
enclosure/public/portable-r45/cad/portrait-stand.step
enclosure/public/portable-r45/assembly/accessory-cap-portrait-left.stl
enclosure/public/pebble-r26-prototype-v2/cad/tv-antenna-left.step
enclosure/public/portable-r45/assembly/display-carrier-left.stl
enclosure/public/portable-r45/assembly/bunny-ear-right-portrait.stl
enclosure/public/portable-r45/assembly/eye-left.stl
enclosure/public/pebble-r26-prototype-v2/cad/eye-left.step
enclosure/public/pebble-r26-prototype-v2/cad/accessory-blank-cap-right.step
enclosure/public/pebble-r26-prototype-v2/cad/saddle-right.step
enclosure/public/pebble-r26-prototype-v2/cad/eye-foot-right.step
enclosure/public/pebble-r26-prototype-v2/cad/tv-antenna-accent-left.step
enclosure/public/pebble-r26-prototype-v2/cad/rear-screw-cap-left.step
enclosure/public/pebble-r26-prototype-v2/cad/rear-screw-cap-right.step
enclosure/public/pebble-r26-prototype-v2/stl/accessory-blank-cap-left.stl
enclosure/public/pebble-r26-prototype-v2/stl/accessory-blank-cap-right.stl
enclosure/public/pebble-r26-prototype-v2/stl/accessory-collar-left.stl
enclosure/public/pebble-r26-prototype-v2/stl/accessory-fit-socket-strip.stl
enclosure/public/pebble-r26-prototype-v2/stl/accessory-fit-test-pin.stl
enclosure/public/pebble-r26-prototype-v2/stl/battery-hatch-500.stl
enclosure/public/pebble-r26-prototype-v2/stl/battery-tray-500.stl
enclosure/public/pebble-r26-prototype-v2/stl/bunny-ear-accent-left.stl
enclosure/public/pebble-r26-prototype-v2/stl/bunny-ear-accent-right.stl
enclosure/public/pebble-r26-prototype-v2/stl/bunny-ear-left.stl
enclosure/public/pebble-r26-prototype-v2/stl/bunny-ear-right.stl
enclosure/public/pebble-r26-prototype-v2/stl/display-carrier.stl
enclosure/public/pebble-r26-prototype-v2/stl/eye-accent-right.stl
enclosure/public/pebble-r26-prototype-v2/stl/eye-foot-left.stl
enclosure/public/pebble-r26-prototype-v2/stl/eye-foot-right.stl
enclosure/public/pebble-r26-prototype-v2/stl/eye-left.stl
enclosure/public/pebble-r26-prototype-v2/stl/eye-right.stl
enclosure/public/pebble-r26-prototype-v2/stl/input-window-cover-left.stl
enclosure/public/pebble-r26-prototype-v2/stl/input-window-cover-right.stl
enclosure/public/pebble-r26-prototype-v2/stl/power-follower.stl
enclosure/public/pebble-r26-prototype-v2/stl/power-input.stl
enclosure/public/pebble-r26-prototype-v2/stl/purple-body.stl
enclosure/public/pebble-r26-prototype-v2/stl/rear-cover.stl
enclosure/public/pebble-r26-prototype-v2/stl/rear-screw-cap-left.stl
enclosure/public/pebble-r26-prototype-v2/stl/rear-screw-cap-right.stl
enclosure/public/pebble-r26-prototype-v2/stl/saddle-left.stl
enclosure/public/pebble-r26-prototype-v2/stl/saddle-right.stl
enclosure/public/pebble-r26-prototype-v2/stl/tv-antenna-accent-left.stl
enclosure/public/pebble-r26-prototype-v2/stl/tv-antenna-accent-right.stl
enclosure/public/pebble-r26-prototype-v2/stl/tv-antenna-left.stl
enclosure/public/pebble-r26-prototype-v2/stl/tv-antenna-right.stl
enclosure/public/pebble-r26-prototype-v2/stl/white-cradle-500.stl
enclosure/public/portable-r45/assembly/rear-screw-cap-1.stl
enclosure/public/portable-r45/assembly/rear-screw-cap-2.stl
enclosure/public/portable-r45/assembly/rear-screw-cap-3.stl
enclosure/public/portable-r45/assembly/rear-screw-cap-4.stl
enclosure/public/portable-r45/cad/rear-screw-cap-1.step
enclosure/public/portable-r45/cad/rear-screw-cap-2.step
enclosure/public/portable-r45/cad/rear-screw-cap-3.step
enclosure/public/portable-r45/cad/rear-screw-cap-4.step
enclosure/public/portable-r45/stl/accessory-cap-landscape-left.stl
enclosure/public/portable-r45/stl/accessory-cap-landscape-right.stl
enclosure/public/portable-r45/stl/accessory-cap-portrait-left.stl
enclosure/public/portable-r45/stl/accessory-cap-portrait-right.stl
enclosure/public/portable-r45/stl/battery-tray.stl
enclosure/public/portable-r45/stl/bunny-ear-left.stl
enclosure/public/portable-r45/stl/bunny-ear-right.stl
enclosure/public/portable-r45/stl/button-compact.stl
enclosure/public/portable-r45/stl/display-carrier-left.stl
enclosure/public/portable-r45/stl/display-carrier-right.stl
enclosure/public/portable-r45/stl/eye-left.stl
enclosure/public/portable-r45/stl/eye-right.stl
enclosure/public/portable-r45/stl/landscape-stand.stl
enclosure/public/portable-r45/stl/portrait-stand.stl
enclosure/public/portable-r45/stl/purple-body.stl
enclosure/public/portable-r45/stl/purple-rear-cover.stl
enclosure/public/portable-r45/stl/rear-screw-cap-3.stl
enclosure/public/portable-r45/stl/tv-antenna-left.stl
enclosure/public/portable-r45/stl/tv-antenna-right.stl
enclosure/public/portable-r45/stl/usb-tunnel.stl
