gkostadinov/glimdock/design/agent-operations/README.md

# Glimdock agent operations prototype

Serve this interactive firmware-view design with
`python tools/agent-operations/api.py --hub /PATH/TO/SHARED-COORDINATION-DIRECTORY`.
The UI and reference API are separate from the installed firmware.

See [Agent operations](../../public-docs/AGENT-OPERATIONS.md) for the coordinated
source contract, portable API, setup, state semantics and validation.
