gkostadinov/glimdock/BUILDING.md

# Build Glimdock

The current guide is [Build Glimdock](public-docs/BUILDING.md).
