gkostadinov/glimdock/public-docs/SETUP.md

# Set up Glimdock

Use [the canonical setup guide](../SETUP.md). It covers the one-command Linux/macOS
collector, its built-in web console, single-use push-agent pairing, display pairing,
Chrome/Edge USB firmware updates and optional Linux systemd installation.

For an additional monitored machine or router, follow [DEVICES.md](DEVICES.md).
To build the complete collector and its embedded assets, follow
[BUILDING.md](BUILDING.md).
