gkostadinov/glimdock/design/agent-operations/nodes.html

GLIMDOCK · HARDWARE WORKSPACE

# Your nodes, at a glance.

Actual firmware with synthetic devices. Use the animated workspace switch or choose Switch to Agents in Pick system.

Sample values only · This local preview does not connect to private nodes.
Use your installed collector for live hardware telemetry.
