gkostadinov/glimdock/design/agent-operations/index.html

GLIMDOCK · LOCAL WORKSPACE

# Your agents, at a glance.

The same interface as your display. Select a hub to see its details.

Loading source…JSON API schema ↗

Hardware readings in this local preview are synthetic.
Agent metadata comes from the configured read-only source. Optional history review opens in a separate authenticated chat reader.
