gkostadinov/glimdock/public-docs/VALIDATION.md

# Validation scope

The version 0.3 centralized Glimdock runtime is tested as a Linux/macOS Rust
server with native push agents and an embedded web console. Current CI checks
workspace tests, native agents on Linux/macOS/Windows, public firmware and
WebAssembly behavior, pointer handling and public source packaging.

The combined `run` integration checks initialization without replacing saved
state, distinct credentials and loopback/remote roles, registered feed editing,
configuration conflicts, optional-host removal and an empty registry. Concurrent
runs are rejected. Startup failures and SIGTERM release listeners, private
sockets, locks and bounded probe workers.

Push coverage includes one-time enrollment, exact lost-response recovery after
grant expiry, scoped publisher credentials, durable private state, duplicate
and retired-session rejection, bounded latest-sample delivery, network retry,
sample expiry and node pause/revoke/re-pair. Polling-to-push migration retains
the node identity. OS, SNMP and mapped JSON collectors use the same push
transport; device-specific readings remain labeled by their source.

The shared firmware renderer has passed a full 320 × 240 native/WebAssembly
pixel comparison. The All nodes view and selected-node navigation are exercised
through real LVGL input. The website runs this renderer with explicitly authored
example Mac, Windows, router and printer readings.

The configuration parser retains up to sixteen saved nodes and limits active
nodes to four. Pointer and WebAssembly checks cover paused nodes, agent edits,
capacity, duplicate identities and active selection. Publisher credentials are
held by the agent and are never copied into display settings.

The public firmware image was programmed to a physical V1 display through the
guarded command-line uploader, and it reconnected using saved NVS pairing.
Chrome/Edge Web Serial image planning and hash-verification behavior are tested;
a browser-controlled hardware transaction is not yet recorded. Case USB extension
fit and assembled power/data are separate unverified physical checks.

Workspace operational logs and older device observations remain local evidence.
A source or binary package does not contain private addresses, credentials or
live telemetry. Synthetic snapshots in `examples/` are labeled as examples.
