gkostadinov/glimdock/enclosure/public/pebble-r26-prototype-v2/CHANGES.md

# Package v2 — 2026-10-13

Corrected the first package's overly broad MIT license statement to preserve
the existing project policy: CERN-OHL-P-2.0 for original enclosure CAD and
geometry meshes; MIT for the generic exporter, documentation and renders.
Added full license texts, a scope index and per-asset SPDX notices.

No CAD, BREP, STL or PNG bytes changed. Prototype fit, print and electrical
validation caveats are unchanged. The r26 print recipe is not included.
This is a metadata correction, not a new geometry or hardware release.
