gkostadinov/glimdock/collector-rs/src/probes.rs

//! Native local collector: independent single-flight, expiring source caches.
use crate::{
    config::Config,
    energy::{EnergyMeter, Input as EnergyInput},
    guest_config::{GuestConfigReader, Roster},
    guests::{GuestEpoch, GuestReader, GPU_METRICS},
    procfs::ProcReader,
    proxmox::ProxmoxReader,
    runtime::{bounded_snapshot, empty_snapshot},
    truenas::TrueNasReader,
};
use serde_json::{json, Value};
use std::{
    cell::RefCell,
    collections::{BTreeMap, BTreeSet},
    io::Read,
    os::unix::process::CommandExt,
    process::{Command, Stdio},
    sync::{
        atomic::{AtomicBool, Ordering},
        Arc, Mutex, OnceLock,
    },
    time::{Duration, Instant},
};
use tokio::{sync::Semaphore, task::JoinHandle};
thread_local! {
    static CANCELLATION: RefCell<Option<Arc<AtomicBool>>> = const { RefCell::new(None) };
}
fn probe_cancelled() -> bool {
    CANCELLATION.with(|flag| {
        flag.borrow()
            .as_ref()
            .is_some_and(|flag| flag.load(Ordering::Acquire))
    })
}
fn cancellable_probe<T>(flag: Arc<AtomicBool>, work: impl FnOnce() -> T) -> T {
    struct Restore(Option<Arc<AtomicBool>>);
    impl Drop for Restore {
        fn drop(&mut self) {
            CANCELLATION.with(|flag| {
                flag.replace(self.0.take());
            });
        }
    }
    let _restore = Restore(CANCELLATION.with(|current| current.replace(Some(flag))));
    work()
}
pub fn num(v: &Value) -> Option<f64> {
    match v {
        Value::Number(n) => n.as_f64(),
        Value::String(s) => s.trim().parse::<f64>().ok(),
        _ => None,
    }
    .filter(|v| v.is_finite())
}
pub fn text(s: &str, max: usize) -> String {
    s.chars()
        .map(|c| if c.is_control() { ' ' } else { c })
        .take(max)
        .collect()
}
pub fn round(v: f64, digits: i32) -> f64 {
    let p = 10_f64.powi(digits);
    (v * p).round() / p
}
pub fn wall() -> f64 {
    crate::epoch()
}
pub fn monotonic() -> f64 {
    static START: OnceLock<Instant> = OnceLock::new();
    START.get_or_init(Instant::now).elapsed().as_secs_f64()
}
pub struct CommandOutput {
    pub stdout: String,
    pub stderr: String,
    pub status: i32,
}
/// Fixed executable and argv, no shell; each pipe is drained and bounded.
/// Kill/reap timed-out children; callers never accept user-supplied commands.
pub fn command(
    program: &str,
    args: &[&str],
    timeout: f64,
    allow_nonzero: bool,
) -> anyhow::Result<CommandOutput> {
    if probe_cancelled() {
        anyhow::bail!("Probe cancelled");
    }
    let mut child = Command::new(program)
        .args(args)
        .env("LC_ALL", "C")
        .env("LANG", "C")
        .stdin(Stdio::null())
        .stdout(Stdio::piped())
        .stderr(Stdio::piped())
        .process_group(0)
        .spawn()
        .map_err(|_| anyhow::anyhow!("{program} unavailable"))?;
    let read_pipe = |mut pipe: Box<dyn Read + Send>| {
        std::thread::spawn(move || {
            let mut data = Vec::new();
            let mut buf = [0u8; 8192];
            let mut exceeded = false;
            loop {
                match pipe.read(&mut buf) {
                    Ok(0) => break,
                    Ok(n) => {
                        if data.len() + n > 4 * 1024 * 1024 {
                            exceeded = true
                        } else {
                            data.extend_from_slice(&buf[..n])
                        }
                    }
                    Err(_) => break,
                }
            }
            (data, exceeded)
        })
    };
    let out = read_pipe(Box::new(child.stdout.take().unwrap()));
    let err = read_pipe(Box::new(child.stderr.take().unwrap()));
    let deadline = Instant::now() + Duration::from_secs_f64(timeout);
    let mut timed_out = false;
    let mut cancelled = false;
    let status = loop {
        if let Some(status) = child.try_wait()? {
            break status;
        }
        if probe_cancelled() || Instant::now() >= deadline {
            cancelled = probe_cancelled();
            timed_out = !cancelled;
            // Probe helpers can launch their own children. Their dedicated
            // process group prevents inherited output pipes from outliving a
            // cancelled probe or its timeout.
            unsafe {
                libc::kill(-(child.id() as i32), libc::SIGKILL);
            }
            let _ = child.kill();
            break child.wait()?;
        }
        std::thread::sleep(Duration::from_millis(20))
    };
    let (stdout, overout) = out
        .join()
        .map_err(|_| anyhow::anyhow!("output reader failed"))?;
    let (stderr, overerr) = err
        .join()
        .map_err(|_| anyhow::anyhow!("output reader failed"))?;
    if cancelled {
        anyhow::bail!("Probe cancelled");
    }
    if timed_out {
        anyhow::bail!("{program} probe timed out")
    };
    if overout || overerr {
        anyhow::bail!("{program} output exceeds bound")
    };
    let result = CommandOutput {
        stdout: String::from_utf8_lossy(&stdout).into_owned(),
        stderr: String::from_utf8_lossy(&stderr).into_owned(),
        status: status.code().unwrap_or(1),
    };
    if result.status != 0 && !allow_nonzero {
        anyhow::bail!(
            "{program} exit {}: {}",
            result.status,
            text(&result.stderr, 120)
        )
    };
    Ok(result)
}
fn command_available(program: &str) -> bool {
    use std::os::unix::fs::PermissionsExt;
    std::env::var_os("PATH").is_some_and(|path| {
        std::env::split_paths(&path).any(|dir| {
            std::fs::metadata(dir.join(program))
                .is_ok_and(|m| m.is_file() && m.permissions().mode() & 0o111 != 0)
        })
    })
}
type Job = Arc<dyn Fn() -> anyhow::Result<Value> + Send + Sync>;
struct Source {
    job: Job,
    interval: f64,
    ttl: f64,
    enabled: bool,
    handle: Option<JoinHandle<(u64, anyhow::Result<Value>)>>,
    generation: u64,
    next_run: f64,
    data: Option<Value>,
    updated_at: Option<f64>,
    updated_mono: Option<f64>,
    ok: bool,
    last_succeeded: bool,
    error: Option<String>,
    cancellation: Arc<AtomicBool>,
}
impl Drop for Source {
    fn drop(&mut self) {
        self.cancellation.store(true, Ordering::Release);
        if let Some(handle) = &self.handle {
            handle.abort();
        }
    }
}
impl Source {
    fn new(job: Job, interval: f64, ttl: f64, enabled: bool) -> Self {
        Self {
            job,
            interval,
            ttl,
            enabled,
            handle: None,
            generation: 0,
            next_run: 0.,
            data: None,
            updated_at: None,
            updated_mono: None,
            ok: false,
            last_succeeded: false,
            error: Some("initializing".into()),
            cancellation: Arc::new(AtomicBool::new(false)),
        }
    }
    fn reset(&mut self) {
        self.generation += 1;
        self.data = None;
        self.updated_at = None;
        self.updated_mono = None;
        self.ok = false;
        self.last_succeeded = false;
        self.error = Some("Guest changed; waiting for OS sample".into());
        self.next_run = 0.;
    }
    fn commit(&mut self, result: (u64, anyhow::Result<Value>), mono: f64, wall: f64) {
        if result.0 != self.generation {
            return;
        }
        match result.1 {
            Ok(data) => {
                self.error = data["error"]
                    .as_str()
                    .filter(|s| !s.is_empty())
                    .map(|s| text(s, 180));
                self.ok = self.error.is_none();
                self.last_succeeded = true;
                self.data = Some(data);
                self.updated_at = Some(wall);
                self.updated_mono = Some(mono)
            }
            Err(e) => {
                self.ok = false;
                self.last_succeeded = false;
                self.error = Some(text(&e.to_string(), 180));
            }
        }
    }
    async fn advance(&mut self, mono: f64, wall: f64, semaphore: Arc<Semaphore>) {
        if !self.enabled {
            self.error = Some("disabled in configuration".into());
            return;
        }
        if self.handle.as_ref().is_some_and(JoinHandle::is_finished) {
            if let Ok(result) = self.handle.take().unwrap().await {
                self.commit(result, mono, wall)
            } else {
                self.ok = false;
                self.last_succeeded = false;
                self.error = Some("Source worker failed".into())
            }
        }
        if self.handle.is_none() && mono >= self.next_run {
            let job = self.job.clone();
            let generation = self.generation;
            let cancellation = self.cancellation.clone();
            self.handle = Some(tokio::spawn(async move {
                let permit = semaphore.acquire_owned().await;
                let result = if let Ok(_permit) = permit {
                    match tokio::task::spawn_blocking(move || {
                        cancellable_probe(cancellation, || job())
                    })
                    .await
                    {
                        Ok(r) => r,
                        Err(_) => Err(anyhow::anyhow!("Source worker failed")),
                    }
                } else {
                    Err(anyhow::anyhow!("Source queue unavailable"))
                };
                (generation, result)
            }));
            self.next_run = mono + self.interval
        }
    }
    async fn initialize(&mut self) {
        if let Some(handle) = self.handle.take() {
            if let Ok(result) = handle.await {
                self.commit(result, monotonic(), wall())
            }
        }
    }
    fn current(&self, mono: f64) -> Option<&Value> {
        if !self.enabled || !self.updated_mono.is_some_and(|t| mono - t <= self.ttl) {
            None
        } else {
            self.data.as_ref()
        }
    }
    fn status(&self, mono: f64) -> Value {
        let age = self.updated_mono.map(|t| round((mono - t).max(0.), 1));
        let expired = age.is_some_and(|a| a > self.ttl);
        json!({"ok":self.enabled&&self.ok&&!expired,"enabled":self.enabled,"updated_at":self.updated_at,"age_s":age,"error":if !self.enabled{Some("disabled in configuration")}else if expired{Some("sample expired")}else{self.error.as_deref()}})
    }
}
pub struct LocalCollector {
    proc: ProcReader,
    energy: EnergyMeter,
    guest_roster: Roster,
    sources: BTreeMap<String, Source>,
    guest_epochs: BTreeMap<u64, GuestEpoch>,
    guest_states: BTreeMap<u64, (String, Option<f64>, Option<f64>)>,
    nas_reset_at: f64,
    semaphore: Arc<Semaphore>,
}
impl LocalCollector {
    pub fn new(c: &Config) -> Self {
        let mut sources = BTreeMap::new();
        let proxmox = c.local_type == "proxmox";
        let sensors_tool = proxmox || command_available("sensors");
        let pve = Arc::new(Mutex::new(ProxmoxReader::default()));
        let nas = Arc::new(Mutex::new(TrueNasReader::default()));
        let c1 = c.clone();
        sources.insert(
            "proxmox".into(),
            Source::new(
                Arc::new(move || {
                    pve.lock()
                        .map_err(|_| anyhow::anyhow!("PVE state unavailable"))?
                        .read(&c1)
                }),
                c.proxmox_interval_s,
                (3. * c.proxmox_interval_s).max(30.),
                proxmox,
            ),
        );
        sources.insert(
            "sensors".into(),
            Source::new(
                Arc::new(move || {
                    let readings = if sensors_tool {
                        let r = command("sensors", &["-j"], 5., false)?;
                        let d: Value = serde_json::from_str(&r.stdout)?;
                        crate::sensors::parse_sensors(&d)
                    } else {
                        crate::sensors::read_hwmon(std::path::Path::new("/sys/class/hwmon"))?
                    };
                    Ok(json!({"sensors":readings}))
                }),
                c.sensor_interval_s,
                (3. * c.sensor_interval_s).max(20.),
                sensors_tool || std::path::Path::new("/sys/class/hwmon").is_dir(),
            ),
        );
        sources.insert(
            "turbostat".into(),
            Source::new(
                Arc::new(|| {
                    let r = command(
                        "turbostat",
                        &[
                            "--quiet",
                            "--Summary",
                            "--interval",
                            "1",
                            "--num_iterations",
                            "1",
                        ],
                        5.,
                        false,
                    )?;
                    Ok(json!({"power":crate::sensors::parse_turbostat(&r.stdout)?}))
                }),
                c.turbostat_interval_s,
                (3. * c.turbostat_interval_s).max(20.),
                c.enable_turbostat && (proxmox || command_available("turbostat")),
            ),
        );
        let c1 = c.clone();
        sources.insert(
            "smart".into(),
            Source::new(
                Arc::new(move || crate::storage::read_smart(&c1)),
                c.smart_interval_s,
                (3. * c.smart_interval_s).max(900.),
                c.enable_smart && (proxmox || command_available("smartctl")),
            ),
        );
        sources.insert(
            "zfs".into(),
            Source::new(
                Arc::new(crate::storage::read_zfs),
                c.zfs_interval_s,
                (3. * c.zfs_interval_s).max(90.),
                c.enable_zfs && (proxmox || command_available("zpool")),
            ),
        );
        let c1 = c.clone();
        sources.insert(
            "nas".into(),
            Source::new(
                Arc::new(move || {
                    nas.lock()
                        .map_err(|_| anyhow::anyhow!("NAS state unavailable"))?
                        .read(&c1)
                }),
                c.truenas_interval_s,
                (3. * c.truenas_interval_s).max(90.),
                proxmox && !c.truenas_ssh_host.is_empty(),
            ),
        );
        sources.insert(
            "faults".into(),
            Source::new(
                Arc::new(crate::faults::read_faults),
                c.faults_interval_s,
                (3. * c.faults_interval_s).max(90.),
                c.enable_faults && (proxmox || command_available("journalctl")),
            ),
        );
        sources.insert(
            "gpus".into(),
            Source::new(
                Arc::new(crate::gpus::read_gpus),
                c.gpu_interval_s,
                (3. * c.gpu_interval_s).max(90.),
                c.enable_gpus,
            ),
        );
        sources.insert(
            "filesystems".into(),
            Source::new(
                Arc::new(crate::storage::read_filesystems),
                c.zfs_interval_s,
                (3. * c.zfs_interval_s).max(90.),
                !proxmox,
            ),
        );
        // Guest CPU configuration is its own source: a slow `pvesh` config read
        // never delays the guest inventory, and each guest is read at most once
        // a minute. It exists only where the Proxmox source does.
        let guest_roster = Roster::default();
        if proxmox {
            let reader = Arc::new(Mutex::new(GuestConfigReader::new(
                if c.node.is_empty() {
                    crate::procfs::hostname()
                } else {
                    c.node.clone()
                },
                guest_roster.clone(),
            )));
            sources.insert(
                "guest_configs".into(),
                Source::new(
                    Arc::new(move || {
                        reader
                            .lock()
                            .map_err(|_| anyhow::anyhow!("Guest configuration state unavailable"))?
                            .read()
                    }),
                    c.proxmox_interval_s,
                    (3. * c.proxmox_interval_s).max(30.),
                    true,
                ),
            );
        }
        let mut guest_epochs = BTreeMap::new();
        for id in c.qga_guest_ids.iter().filter(|_| proxmox) {
            let epoch = GuestEpoch::default();
            let reader = Arc::new(Mutex::new(GuestReader::new(*id, epoch.clone())));
            guest_epochs.insert(*id, epoch);
            sources.insert(
                format!("guest_{id}"),
                Source::new(
                    Arc::new(move || {
                        reader
                            .lock()
                            .map_err(|_| anyhow::anyhow!("Guest state unavailable"))?
                            .read()
                    }),
                    c.guest_interval_s,
                    (3. * c.guest_interval_s).max(45.),
                    true,
                ),
            );
        }
        Self {
            proc: ProcReader::default(),
            energy: EnergyMeter::open(c.state_dir.as_deref(), "/sys", wall()),
            guest_roster,
            sources,
            guest_epochs,
            guest_states: BTreeMap::new(),
            nas_reset_at: 0.,
            semaphore: Arc::new(Semaphore::new(10)),
        }
    }
    pub async fn initialize(&mut self) {
        for source in self.sources.values_mut() {
            source.initialize().await
        }
    }
    /// Continue another collector's running energy counter (a configuration
    /// reload builds a replacement; the counter must not restart or lose time).
    pub fn take_energy_from(&mut self, other: &mut Self) {
        std::mem::swap(&mut self.energy, &mut other.energy);
    }
    fn observe_guests(&mut self, guests: &[Value], c: &Config, wall: f64) {
        let mut present = BTreeSet::new();
        for g in guests {
            let Some(id) = g["id"].as_u64() else { continue };
            present.insert(id);
            let state = (
                g["status"].as_str().unwrap_or("unknown").to_owned(),
                num(&g["uptime_s"]),
                num(&g["mem_total_bytes"]),
            );
            if let Some(old) = self.guest_states.get(&id) {
                let rebooted = matches!((state.1,old.1),(Some(a),Some(b))if a<b);
                if old.0 != state.0 || old.2 != state.2 || rebooted {
                    if let Some(epoch) = self.guest_epochs.get(&id) {
                        epoch.reset(old.0 != state.0 || rebooted);
                        if let Some(s) = self.sources.get_mut(&format!("guest_{id}")) {
                            s.reset()
                        }
                    }
                    if id == c.truenas_guest_id {
                        self.nas_reset_at = wall
                    }
                }
            }
            self.guest_states.insert(id, state);
        }
        let removed = self
            .guest_states
            .keys()
            .filter(|id| !present.contains(id))
            .copied()
            .collect::<Vec<_>>();
        for id in removed {
            self.guest_states.remove(&id);
            if let Some(epoch) = self.guest_epochs.get(&id) {
                epoch.reset(true);
                if let Some(s) = self.sources.get_mut(&format!("guest_{id}")) {
                    s.reset()
                }
            }
            if id == c.truenas_guest_id {
                self.nas_reset_at = wall
            }
        }
    }
    pub async fn collect(&mut self, c: &Config, sequence: u64) -> Value {
        let mono = monotonic();
        let now = wall();
        let mut snapshot = empty_snapshot(&crate::procfs::hostname(), &c.host_ip, sequence, now);
        if c.local_type == "server" {
            snapshot["platform"] = json!({
                "os":"linux",
                "release":std::fs::read_to_string("/proc/sys/kernel/osrelease").map(|s|text(s.trim(),96)).ok(),
                "version":std::fs::read_to_string("/proc/version").map(|s|text(s.trim(),160)).ok(),
                "architecture":std::env::consts::ARCH,
                "cpu_count":std::thread::available_parallelism().ok().map(|n|n.get()),
            });
        }
        let proc = self.proc.read(c, mono);
        snapshot["host"] = proc["host"].clone();
        snapshot["sources"]["proc"] = json!({"ok":proc["error"].is_null(),"enabled":true,"updated_at":now,"age_s":0,"error":proc["error"]});
        for source in self.sources.values_mut() {
            source.advance(mono, now, self.semaphore.clone()).await;
        }
        let pve = self.sources["proxmox"].current(mono).cloned();
        if let Some(pve) = pve.as_ref() {
            if let Some(guests) = pve["guests"].as_array() {
                self.observe_guests(guests, c, now);
                crate::guest_config::publish_roster(&self.guest_roster, guests)
            }
        }
        for (name, source) in &self.sources {
            snapshot["sources"][name] = source.status(mono);
        }
        // Assembly order is semantic: local inventories form the base, then
        // ZFS and NAS append to them. Map iteration must never overwrite NAS.
        for name in [
            "proxmox",
            "filesystems",
            "sensors",
            "turbostat",
            "smart",
            "zfs",
            "nas",
            "faults",
            "gpus",
        ] {
            let source = &self.sources[name];
            let Some(data) = source.current(mono) else {
                continue;
            };
            match name {
                "proxmox" => {
                    snapshot["guests"] = data["guests"].clone();
                    snapshot["storage"] = data["storage"].clone();
                    snapshot["sources"]["proxmox_node"] = json!({"ok":data["node_error"].is_null(),"updated_at":source.updated_at,"age_s":source.status(mono)["age_s"],"error":data["node_error"]});
                    if !data["io_wait_pct"].is_null() {
                        snapshot["host"]["io_wait_pct"] = data["io_wait_pct"].clone()
                    }
                }
                "filesystems" => snapshot["storage"] = data["storage"].clone(),
                "sensors" => snapshot["sensors"] = data["sensors"].clone(),
                "turbostat" => snapshot["power"] = data["power"].clone(),
                "smart" => {
                    snapshot["disks"] = data["disks"].clone();
                    snapshot["limits"]["counts"]["disks"] = data["disks_total"].clone()
                }
                "zfs" => {
                    if let Some(pools) = data["pools"].as_array() {
                        for p in pools {
                            let mut pool = p.clone();
                            pool["id"] =
                                json!(format!("zpool/{}", p["name"].as_str().unwrap_or("")));
                            snapshot["storage"].as_array_mut().unwrap().push(pool)
                        }
                    }
                }
                "nas" => {
                    snapshot["limits"]["counts"]["storage"] = json!(
                        snapshot["storage"].as_array().unwrap().len()
                            + data["storage"]
                                .as_array()
                                .map_or(0, Vec::len)
                                .max(data["counts"]["pools"].as_u64().unwrap_or(0) as usize)
                    );
                    snapshot["limits"]["counts"]["disks"] = json!(
                        snapshot["disks"]
                            .as_array()
                            .unwrap()
                            .len()
                            .max(snapshot["limits"]["counts"]["disks"].as_u64().unwrap_or(0)
                                as usize)
                            + data["disks"]
                                .as_array()
                                .map_or(0, Vec::len)
                                .max(data["counts"]["disks"].as_u64().unwrap_or(0) as usize)
                    );
                    for field in ["storage", "disks", "alerts"] {
                        if let Some(items) = data[field].as_array() {
                            snapshot[field]
                                .as_array_mut()
                                .unwrap()
                                .extend(items.clone())
                        }
                    }
                    snapshot["sources"]["nas"]["temperature_cache_interval_s"] =
                        data["temperature_cache_interval_s"].clone()
                }
                "faults" => snapshot["faults"] = data["faults"].clone(),
                _ => {}
            }
        }
        let mut guest_data = BTreeMap::new();
        let mut memory_states = BTreeMap::new();
        for id in c.qga_guest_ids.iter().filter(|_| c.local_type == "proxmox") {
            let source = &self.sources[&format!("guest_{id}")];
            let mut state = source.status(mono);
            let current = source.current(mono);
            if let Some(d) = current {
                state["updated_at"] = d["generated_at"].clone();
                state["age_s"] = json!(num(&d["generated_at"]).map(|t| (now - t).max(0.)));
                if num(&state["age_s"]).is_none_or(|a| a > source.ttl) {
                    state["ok"] = json!(false);
                    state["error"] = json!("Guest OS sample expired")
                }
            }
            if state["ok"] == true {
                if let Some(d) = current {
                    guest_data.insert(*id, d.clone());
                }
            }
            snapshot["sources"][format!("guest_{id}")] = state.clone();
            memory_states.insert(*id, state);
        }
        let mut enabled = c
            .qga_guest_ids
            .iter()
            .filter(|_| c.local_type == "proxmox")
            .copied()
            .collect::<BTreeSet<_>>();
        if c.local_type == "proxmox" && !c.truenas_ssh_host.is_empty() {
            let id = c.truenas_guest_id;
            enabled.insert(id);
            let source = &self.sources["nas"];
            let data = source.current(mono);
            let mut state = source.status(mono);
            let error = if let Some(d) = data {
                if num(&d["generated_at"]).is_none_or(|t| t < self.nas_reset_at) {
                    Some("Guest changed; waiting for NAS OS sample")
                } else if num(&d["generated_at"]).is_none_or(|t| now - t > source.ttl) {
                    Some("NAS OS memory sample expired")
                } else {
                    d["memory_error"].as_str().or(if d["memory"].is_null() {
                        Some("NAS OS memory unavailable")
                    } else {
                        None
                    })
                }
            } else {
                state["error"].as_str()
            };
            let error = error.map(str::to_owned);
            state["ok"] = json!(data.is_some() && source.last_succeeded && error.is_none());
            state["error"] = json!(error);
            if state["ok"] == true {
                let d = data.unwrap();
                guest_data.insert(
                    id,
                    json!({"memory":d["memory"],"generated_at":d["generated_at"],"gpus":[]}),
                );
            }
            memory_states.insert(id, state);
        }
        let guests = snapshot["guests"].as_array().cloned().unwrap_or_default();
        snapshot["guests"] = json!(crate::guests::merge_guest_memory(
            &guests,
            &guest_data,
            &memory_states,
            &enabled,
            c.truenas_guest_id,
            &snapshot["sources"]["proxmox"],
            now
        ));
        if let Some(data) = self
            .sources
            .get("guest_configs")
            .and_then(|s| s.current(mono))
        {
            if let Some(guests) = snapshot["guests"].as_array_mut() {
                crate::guest_config::apply(guests, &data["configs"])
            }
        }
        if let Some(inv) = self.sources["gpus"].current(mono) {
            if let Some(gpus) = inv["gpus"].as_array() {
                let mut gpus = crate::gpus::merge_gpus(
                    gpus,
                    &guest_data,
                    snapshot["guests"].as_array().unwrap(),
                    &snapshot["sources"],
                    now,
                );
                if snapshot["sources"]["gpus"]["ok"] != true {
                    for g in &mut gpus {
                        for k in GPU_METRICS {
                            g[k] = Value::Null
                        }
                        g["status"] = json!("unavailable");
                        g["error"] = snapshot["sources"]["gpus"]["error"].clone()
                    }
                }
                snapshot["gpus"] = json!(gpus)
            }
        }
        if snapshot["power"]["cpu_temp_c"].is_null() {
            let re = regex::Regex::new(r"(?i)coretemp|k10temp|zenpower|cpu_thermal").unwrap();
            let max = snapshot["sensors"]
                .as_array()
                .into_iter()
                .flatten()
                .filter(|s| {
                    s["kind"] == "temperature" && re.is_match(s["chip"].as_str().unwrap_or(""))
                })
                .filter_map(|s| num(&s["value"]))
                .reduce(f64::max);
            snapshot["power"]["cpu_temp_c"] = json!(max)
        }
        snapshot["sensors"] = json!(crate::sensors::merge_power_sensors(&snapshot, c));
        // The energy counter is a reading of its own: present only on a host
        // that has an energy source, so other snapshots keep their exact shape.
        self.energy
            .observe(&EnergyInput::from_snapshot(&snapshot), now, mono);
        if let Some(energy) = self.energy.snapshot() {
            snapshot["energy"] = energy;
            snapshot["sources"]["energy"] = self.energy.status(now);
        }
        let disks = snapshot["disks"].as_array_mut().unwrap();
        for disk in disks.iter_mut() {
            if let Some((read, write)) = disk["name"]
                .as_str()
                .and_then(|n| self.proc.disk_rates.get(n))
            {
                disk["read_bps"] = json!(read);
                disk["write_bps"] = json!(write)
            }
        }
        let known = disks
            .iter()
            .filter_map(|d| d["name"].as_str().map(str::to_owned))
            .collect::<BTreeSet<_>>();
        for name in &self.proc.devices {
            if !known.contains(name) {
                let (read, write) = self
                    .proc
                    .disk_rates
                    .get(name)
                    .copied()
                    .unwrap_or((None, None));
                disks.push(json!({"name":name,"model":"","temp_c":null,"health":null,"status":"unknown","read_bps":read,"write_bps":write}))
            }
        }
        snapshot["limits"]["network_interfaces"] = json!(self.proc.interfaces);
        snapshot["limits"]["disk_devices"] = json!(self.proc.devices);
        snapshot["alerts"] = json!(generate_alerts(&snapshot, c));
        bounded_snapshot(snapshot)
    }
}
pub fn generate_alerts(s: &Value, c: &Config) -> Vec<Value> {
    let mut alerts = s["alerts"].as_array().cloned().unwrap_or_default();
    let h = &s["host"];
    let memory = num(&h["mem_used_bytes"])
        .zip(num(&h["mem_total_bytes"]).filter(|v| *v > 0.))
        .map(|(u, t)| u * 100. / t);
    limit_alert(
        &mut alerts,
        "host/memory",
        "RAM used",
        memory,
        c.memory_warning_pct,
        c.memory_critical_pct,
        "%",
    );
    limit_alert(
        &mut alerts,
        "host/iowait",
        "IO wait",
        num(&h["io_wait_pct"]),
        c.io_wait_warning_pct,
        c.io_wait_critical_pct,
        "%",
    );
    limit_alert(
        &mut alerts,
        "host/temperature",
        "CPU temperature",
        num(&s["power"]["cpu_temp_c"]),
        c.temperature_warning_c,
        c.temperature_critical_c,
        "°C",
    );
    for sensor in s["sensors"].as_array().into_iter().flatten() {
        let id = sensor["id"].as_str().unwrap_or("sensor");
        let name = sensor["name"].as_str().unwrap_or("Sensor");
        if sensor["fault"] == true {
            push(
                &mut alerts,
                format!("{id}/fault"),
                "warning",
                format!("{name} sensor fault"),
            )
        }
        if sensor["alarm"] == true {
            push(
                &mut alerts,
                format!("{id}/alarm"),
                "critical",
                format!("{name} hardware sensor alarm"),
            )
        }
        if sensor["kind"] == "temperature" {
            limit_alert(
                &mut alerts,
                id,
                name,
                num(&sensor["value"]),
                num(&sensor["high"]).unwrap_or(c.temperature_warning_c),
                num(&sensor["crit"]).unwrap_or(c.temperature_critical_c),
                "°C",
            )
        }
    }
    for d in s["disks"].as_array().into_iter().flatten() {
        let name = d["name"].as_str().unwrap_or("disk");
        if d["health"] == "failed" {
            push(
                &mut alerts,
                format!("disk/{name}/smart"),
                "critical",
                format!("{name} SMART health failed"),
            )
        } else if d["status"] == "error" {
            push(
                &mut alerts,
                format!("disk/{name}/read"),
                "warning",
                format!("{name} SMART unavailable"),
            )
        }
        let (warning, critical) = if crate::storage::is_nvme_disk(d) {
            (c.nvme_temperature_warning_c, c.nvme_temperature_critical_c)
        } else {
            (c.disk_temperature_warning_c, c.disk_temperature_critical_c)
        };
        limit_alert(
            &mut alerts,
            &format!("disk/{name}/temperature"),
            name,
            num(&d["temp_c"]),
            warning,
            critical,
            "°C",
        );
        for (i, w) in d["warnings"].as_array().into_iter().flatten().enumerate() {
            push(
                &mut alerts,
                format!("disk/{name}/warning{i}"),
                "warning",
                format!("{name}: {}", w.as_str().unwrap_or("SMART warning")),
            )
        }
        for (field, title) in [
            ("reallocated_sectors", "reallocated sectors"),
            ("pending_sectors", "pending sectors"),
        ] {
            if let Some(v) = num(&d[field]).filter(|v| *v != 0.) {
                push(
                    &mut alerts,
                    format!("disk/{name}/{field}"),
                    if field == "pending_sectors" {
                        "critical"
                    } else {
                        "warning"
                    },
                    format!("{name}: {v:.0} {title}"),
                )
            }
        }
        if ["DEGRADED", "FAULTED", "UNAVAIL", "OFFLINE", "REMOVED"]
            .contains(&d["zfs_status"].as_str().unwrap_or(""))
        {
            push(
                &mut alerts,
                format!("disk/{name}/zfs"),
                "critical",
                format!("{name} ZFS {}", d["zfs_status"].as_str().unwrap()),
            )
        }
        for field in ["read_errors", "write_errors", "checksum_errors"] {
            if let Some(v) = num(&d[field]).filter(|v| *v != 0.) {
                push(
                    &mut alerts,
                    format!("disk/{name}/{field}"),
                    "critical",
                    format!("{name}: {v:.0} ZFS {}", field.replace('_', " ")),
                )
            }
        }
    }
    for st in s["storage"].as_array().into_iter().flatten() {
        let id = st["id"].as_str().unwrap_or("storage");
        let name = st["name"].as_str().unwrap_or("Storage");
        let pct = num(&st["used_bytes"])
            .zip(num(&st["total_bytes"]).filter(|v| *v > 0.))
            .map(|(a, b)| a * 100. / b);
        limit_alert(
            &mut alerts,
            id,
            &format!("{name} used"),
            pct,
            c.storage_warning_pct,
            c.storage_critical_pct,
            "%",
        );
        if ["offline", "DEGRADED", "FAULTED", "UNAVAIL", "SUSPENDED"]
            .contains(&st["status"].as_str().unwrap_or(""))
        {
            push(
                &mut alerts,
                format!("{id}/health"),
                "critical",
                format!("{name} {}", st["status"].as_str().unwrap()),
            )
        } else if st["healthy"] == false {
            push(
                &mut alerts,
                format!("{id}/health"),
                "critical",
                format!("{name} reports unhealthy"),
            )
        }
        if num(&st["scrub_errors"]).is_some_and(|v| v != 0.) {
            push(
                &mut alerts,
                format!("{id}/scrub"),
                "critical",
                format!("{name}: scrub errors detected"),
            )
        }
    }
    for name in [
        "proc",
        "proxmox",
        "filesystems",
        "sensors",
        "smart",
        "turbostat",
        "zfs",
        "nas",
        "faults",
        "gpus",
    ] {
        let state = &s["sources"][name];
        if state.is_object() && state["enabled"] != false && state["ok"] != true {
            push(
                &mut alerts,
                format!("source/{name}"),
                "warning",
                format!("{name} telemetry unavailable"),
            )
        }
    }
    if s["sources"]["proxmox"]["ok"] == true {
        for id in &c.expected_running_guests {
            let guest = s["guests"]
                .as_array()
                .into_iter()
                .flatten()
                .find(|g| g["id"].as_u64() == Some(*id));
            match guest {
                None => push(
                    &mut alerts,
                    format!("guest/{id}/missing"),
                    "warning",
                    format!("Expected guest {id} absent from node"),
                ),
                Some(g) if g["status"] != "running" => push(
                    &mut alerts,
                    format!("guest/{id}/stopped"),
                    "critical",
                    format!(
                        "{} is {} (expected running)",
                        g["name"].as_str().unwrap_or("Guest"),
                        g["status"].as_str().unwrap_or("unknown")
                    ),
                ),
                _ => {}
            }
        }
    }
    for g in s["guests"].as_array().into_iter().flatten() {
        if g["memory_basis"] != "proxmox" && g["status"] == "running" && !g["mem_error"].is_null() {
            push(
                &mut alerts,
                format!("guest/{}/memory", g["id"].as_u64().unwrap_or(0)),
                "warning",
                format!(
                    "{} OS memory unavailable",
                    g["name"].as_str().unwrap_or("Guest")
                ),
            )
        }
    }
    let faults = &s["faults"];
    if let Some(count) = num(&faults["segfault_count_24h"]).filter(|v| *v > 0.) {
        push(
            &mut alerts,
            "faults/segfaults".into(),
            if count >= 3. { "critical" } else { "warning" },
            format!("{count:.0} segfaults in the last 24h"),
        )
    }
    for e in faults["events"].as_array().into_iter().flatten() {
        if num(&e["timestamp"]).is_some_and(|t| t >= wall() - 86400.) && e["kind"] != "segfault" {
            push(
                &mut alerts,
                format!("faults/{}", e["id"].as_str().unwrap_or("event")),
                if ["hardware", "oom", "lockup"].contains(&e["kind"].as_str().unwrap_or("")) {
                    "critical"
                } else {
                    "warning"
                },
                e["message"].as_str().unwrap_or("Kernel fault").into(),
            )
        }
    }
    alerts.sort_by_key(|a| a["severity"] != "critical");
    alerts.truncate(24);
    alerts
}
fn push(alerts: &mut Vec<Value>, id: String, severity: &str, message: String) {
    alerts.push(json!({"id":text(&id,96),"severity":severity,"message":text(&message,120)}))
}
fn limit_alert(
    alerts: &mut Vec<Value>,
    id: &str,
    title: &str,
    value: Option<f64>,
    warning: f64,
    critical: f64,
    unit: &str,
) {
    if let Some(v) = value.filter(|v| *v >= warning || *v >= critical) {
        push(
            alerts,
            id.into(),
            if v >= critical { "critical" } else { "warning" },
            format!("{title} {v:.0}{unit}"),
        )
    }
}
#[cfg(test)]
mod tests {
    use super::*;
    #[tokio::test]
    async fn ordinary_linux_mode_skips_pve_qga_and_nas_even_with_saved_options() {
        let c = Config {
            local_type: "server".into(),
            qga_guest_ids: vec![100],
            truenas_ssh_host: "nas.example.invalid".into(),
            ..Config::default()
        };
        let mut collector = LocalCollector::new(&c);
        assert!(!collector.sources["proxmox"].enabled);
        assert!(!collector.sources["nas"].enabled);
        assert!(!collector.sources.contains_key("guest_100"));
        assert!(collector.guest_epochs.is_empty());
        assert!(collector.sources["filesystems"].enabled);
        for source in collector.sources.values_mut() {
            source.next_run = f64::INFINITY;
        }
        let snapshot = collector.collect(&c, 1).await;
        assert_eq!(snapshot["platform"]["os"], "linux");
        assert_eq!(snapshot["sources"]["proxmox"]["enabled"], false);
        assert_eq!(snapshot["sources"]["nas"]["enabled"], false);
        assert!(snapshot["sources"].get("guest_100").is_none());
        assert!(!snapshot["alerts"]
            .as_array()
            .unwrap()
            .iter()
            .any(|a| a["id"] == "source/proxmox" || a["id"] == "source/nas"));
        assert!(collector.sources.values().all(|s| s.handle.is_none()));
    }
    #[test]
    fn finite_values_and_text() {
        assert_eq!(num(&json!(true)), None);
        assert_eq!(num(&json!("NaN")), None);
        assert_eq!(num(&json!("2.5")), Some(2.5));
        assert_eq!(text("é\nlong", 3), "é l")
    }
    #[test]
    fn source_expiry_and_failure() {
        let mut s = Source::new(Arc::new(|| Ok(json!({}))), 3., 10., true);
        s.commit((0, Ok(json!({"value":1}))), 10., 100.);
        assert_eq!(s.status(11.)["ok"], true);
        assert!(s.current(21.).is_none());
        assert_eq!(s.status(21.)["error"], "sample expired");
        s.commit((0, Err(anyhow::anyhow!("failed"))), 12., 102.);
        assert_eq!(s.status(12.)["ok"], false);
        s.reset();
        s.commit((0, Ok(json!({"value":2}))), 13., 103.);
        assert!(s.current(13.).is_none());
        assert_eq!(
            s.status(13.)["error"],
            "Guest changed; waiting for OS sample"
        )
    }
    #[test]
    fn guest_lifecycle_invalidation() {
        let c = Config {
            local_type: "proxmox".into(),
            qga_guest_ids: vec![100],
            ..Config::default()
        };
        let mut collector = LocalCollector::new(&c);
        collector.observe_guests(
            &[json!({"id":100,"status":"running","uptime_s":100,"mem_total_bytes":1000})],
            &c,
            10.,
        );
        let source = collector.sources.get_mut("guest_100").unwrap();
        source.commit(
            (
                0,
                Ok(json!({"generated_at":10,"memory":{"mem_used_bytes":500}})),
            ),
            1.,
            10.,
        );
        collector.observe_guests(
            &[json!({"id":100,"status":"running","uptime_s":1,"mem_total_bytes":1000})],
            &c,
            11.,
        );
        assert!(collector.sources["guest_100"].data.is_none());
        assert_eq!(collector.guest_epochs[&100].current(), 1);
        collector.observe_guests(&[], &c, 12.);
        assert_eq!(collector.guest_epochs[&100].current(), 2)
    }
}

#[cfg(test)]
mod command_tests {
    use super::*;
    #[test]
    fn command_timeout_reaps_child() {
        let began = Instant::now();
        let error = command("/bin/sleep", &["1"], 0.04, false).err().unwrap();
        assert!(error.to_string().contains("timed out"));
        assert!(began.elapsed() < Duration::from_secs(1));
    }
    #[test]
    fn command_timeout_reaps_children_that_inherit_output_pipes() {
        let began = Instant::now();
        let error = command("/bin/sh", &["-c", "sleep 10"], 0.04, false)
            .err()
            .unwrap();
        assert!(error.to_string().contains("timed out"));
        assert!(began.elapsed() < Duration::from_secs(1));
    }
    #[test]
    fn nonzero_and_missing_program() {
        assert!(command("/usr/bin/false", &[], 1., false).is_err());
        assert_ne!(command("/usr/bin/false", &[], 1., true).unwrap().status, 0);
        assert!(command("/__glimdock_missing_program__", &[], 1., false).is_err());
    }
    #[tokio::test]
    async fn dropping_source_cancels_and_reaps_its_blocking_probe_child() {
        let (done, mut completed) = tokio::sync::mpsc::channel(1);
        let job = Arc::new(move || {
            let result = command("/bin/sleep", &["10"], 10., false);
            let _ = done.blocking_send(result.as_ref().err().map(ToString::to_string));
            result.map(|_| json!({}))
        });
        let mut source = Source::new(job, 1., 3., true);
        source
            .advance(monotonic(), wall(), Arc::new(Semaphore::new(1)))
            .await;
        tokio::time::sleep(Duration::from_millis(50)).await;
        drop(source);
        let error = tokio::time::timeout(Duration::from_secs(1), completed.recv())
            .await
            .unwrap()
            .unwrap()
            .unwrap();
        assert_eq!(error, "Probe cancelled");
    }
}

#[cfg(test)]
mod alert_tests {
    use super::*;
    #[test]
    fn nvme_temperature_boundaries_keep_sata_and_nas_limits() {
        let config = Config::default();
        for temperature in [49.9, 50., 59.9, 60., 69.9, 70.] {
            let mut s = empty_snapshot("synthetic", "192.0.2.1", 1, 100.);
            s["disks"] = json!([
                {"name":"nvme0n1","temp_c":temperature,"health":"passed"},
                {"name":"NAS/nvme2n1","temp_c":temperature},
                {"name":"named-ssd","protocol":"nVmE","temp_c":temperature},
                {"name":"sda","temp_c":temperature},
                {"name":"NAS/sdb","temp_c":temperature},
                {"name":"nvme3n1","protocol":"ATA","temp_c":temperature},
                {"name":"nvme-archive","model":"NVMe example","temp_c":temperature},
                {"name":"nvme4n1","temp_c":null}
            ]);
            let alerts = generate_alerts(&s, &config);
            for (name, warning, critical) in [
                ("nvme0n1", 60., 70.),
                ("NAS/nvme2n1", 60., 70.),
                ("named-ssd", 60., 70.),
                ("sda", 50., 60.),
                ("NAS/sdb", 50., 60.),
                ("nvme3n1", 50., 60.),
                ("nvme-archive", 50., 60.),
            ] {
                let alert = alerts
                    .iter()
                    .find(|a| a["id"] == format!("disk/{name}/temperature"));
                let expected = if temperature >= critical {
                    Some("critical")
                } else if temperature >= warning {
                    Some("warning")
                } else {
                    None
                };
                assert_eq!(
                    alert.and_then(|a| a["severity"].as_str()),
                    expected,
                    "{name} at {temperature}"
                );
            }
            assert!(!alerts.iter().any(|a| a["id"] == "disk/nvme4n1/temperature"));
        }
    }
    #[test]
    fn nvme_custom_limits_preserve_smart_critical_alerts() {
        let c = Config {
            nvme_temperature_warning_c: 65.,
            nvme_temperature_critical_c: 80.,
            ..Config::default()
        };
        for (temperature, expected) in
            [(60., None), (65., Some("warning")), (80., Some("critical"))]
        {
            let mut s = empty_snapshot("synthetic", "192.0.2.1", 1, 100.);
            s["disks"] = json!([{"name":"nvme0n1","temp_c":temperature,"health":"failed"}]);
            let alerts = generate_alerts(&s, &c);
            assert!(alerts
                .iter()
                .any(|a| a["id"] == "disk/nvme0n1/smart" && a["severity"] == "critical"));
            assert_eq!(
                alerts
                    .iter()
                    .find(|a| a["id"] == "disk/nvme0n1/temperature")
                    .and_then(|a| a["severity"].as_str()),
                expected
            );
        }
    }
    #[test]
    fn hardware_critical_limit_below_default_warning() {
        let mut s = empty_snapshot("synthetic", "192.0.2.1", 1, 100.);
        s["sensors"] = json!([{"id":"nvme/temp1","name":"NVMe","kind":"temperature","value":78,"high":null,"crit":75,"alarm":false,"fault":false}]);
        let alerts = generate_alerts(&s, &Config::default());
        assert!(alerts
            .iter()
            .any(|a| a["id"] == "nvme/temp1" && a["severity"] == "critical"));
    }
    #[test]
    fn disabled_sources_and_current_faults_only() {
        let mut s = empty_snapshot("synthetic", "192.0.2.1", 1, wall());
        s["sources"] =
            json!({"zfs":{"enabled":false,"ok":false},"sensors":{"enabled":true,"ok":false}});
        s["faults"] = json!({"segfault_count_24h":3,"events":[{"id":"old","kind":"hardware","timestamp":wall()-90000.,"message":"Historical fault"},{"id":"now","kind":"hardware","timestamp":wall(),"message":"Current hardware fault"}]});
        let a = generate_alerts(&s, &Config::default());
        assert!(!a
            .iter()
            .any(|a| a["id"] == "source/zfs" || a["id"] == "faults/old"));
        assert!(a.iter().any(|a| a["id"] == "source/sensors"));
        assert!(a
            .iter()
            .any(|a| a["id"] == "faults/segfaults" && a["severity"] == "critical"));
        assert!(a
            .iter()
            .any(|a| a["id"] == "faults/now" && a["severity"] == "critical"));
    }
}

#[cfg(test)]
mod assembly_tests {
    use super::*;
    #[tokio::test]
    async fn nas_inventory_survives_local_inventory_assembly() {
        let folder = tempfile::tempdir().unwrap();
        let proc = folder.path().join("proc");
        let sys = folder.path().join("sys");
        std::fs::create_dir_all(proc.join("net")).unwrap();
        std::fs::create_dir_all(sys.join("block")).unwrap();
        for (file, content) in [
            (
                "stat",
                "cpu 100 0 20 80 10 0 0 0\ncpu0 100 0 20 80 10 0 0 0\n",
            ),
            ("meminfo", "MemTotal: 100 kB\nMemAvailable: 50 kB\n"),
            ("uptime", "100 0\n"),
            ("loadavg", "0.1 0.2 0.3 1/10 100\n"),
            ("diskstats", ""),
            ("net/dev", "eth0: 100 0 0 0 0 0 0 0 100 0 0 0 0 0 0 0\n"),
            (
                "net/route",
                "Iface Destination Gateway Flags\neth0 00000000 00000000 0003\n",
            ),
        ] {
            std::fs::write(proc.join(file), content).unwrap();
        }
        let c = Config {
            local_type: "proxmox".into(),
            truenas_ssh_host: "nas.example.invalid".into(),
            enable_gpus: false,
            enable_faults: false,
            enable_turbostat: false,
            ..Config::default()
        };
        let mut collector = LocalCollector::new(&c);
        collector.proc = ProcReader::new(proc, sys);
        let now = wall();
        let mono = monotonic();
        for source in collector.sources.values_mut() {
            source.next_run = f64::INFINITY;
        }
        let local_disks=(0..2).map(|n|json!({"name":format!("nvme{n}n1"),"model":"synthetic","temp_c":35,"health":"passed","status":"active","read_bps":null,"write_bps":null})).collect::<Vec<_>>();
        let nas_disks=(0..4).map(|n|json!({"name":format!("NAS/disk{n}"),"model":"synthetic","temp_c":40,"health":null,"status":"unknown","zfs_status":"ONLINE","read_bps":null,"write_bps":null})).collect::<Vec<_>>();
        let local_storage=(0..3).map(|n|json!({"id":format!("storage/node/{n}"),"name":format!("Local {n}"),"used_bytes":100,"total_bytes":200,"status":"online"})).collect::<Vec<_>>();
        let nas_storage=(0..2).map(|n|json!({"id":format!("nas/pool/{n}"),"name":format!("NAS {n}"),"used_bytes":100,"total_bytes":200,"status":"ONLINE"})).collect::<Vec<_>>();
        for (name, data) in [
            (
                "proxmox",
                json!({"guests":[],"storage":local_storage,"node_error":null,"io_wait_pct":null}),
            ),
            (
                "smart",
                json!({"disks":local_disks,"disks_total":2,"error":null}),
            ),
            ("zfs", json!({"pools":[]})),
            (
                "nas",
                json!({"disks":nas_disks,"storage":nas_storage,"alerts":[],"memory":null,"memory_error":"Synthetic no VM","counts":{"disks":4,"pools":2},"generated_at":now,"temperature_cache_interval_s":300,"error":null}),
            ),
        ] {
            collector
                .sources
                .get_mut(name)
                .unwrap()
                .commit((0, Ok(data)), mono, now);
        }
        let snapshot = collector.collect(&c, 1).await;
        assert_eq!(snapshot["disks"].as_array().unwrap().len(), 6);
        assert_eq!(snapshot["storage"].as_array().unwrap().len(), 5);
        assert_eq!(snapshot["limits"]["counts"]["disks"], 6);
        assert_eq!(snapshot["limits"]["counts"]["storage"], 5);
        assert_eq!(snapshot["sources"]["nas"]["ok"], true);
        assert!(snapshot["disks"][2]["health"].is_null());
        assert!(snapshot["disks"][2]["name"]
            .as_str()
            .unwrap()
            .starts_with("NAS/"));
    }
}

#[cfg(test)]
mod thread_energy_tests {
    use super::*;
    use crate::guest_config::Kind;
    use std::{fs, path::Path};

    /// A fake /proc and /sys with four CPU rows and nothing else of interest.
    fn fake_host(root: &Path) {
        let proc = root.join("proc");
        fs::create_dir_all(proc.join("net")).unwrap();
        fs::create_dir_all(root.join("sys/block")).unwrap();
        let rows = (0..4)
            .map(|n| format!("cpu{n} 100 0 20 80 10 0 0 0\n"))
            .collect::<String>();
        for (file, content) in [
            ("stat", format!("cpu 400 0 80 320 40 0 0 0\n{rows}")),
            ("meminfo", "MemTotal: 100 kB\nMemAvailable: 50 kB\n".into()),
            ("uptime", "100 0\n".into()),
            ("loadavg", "0.1 0.2 0.3 1/10 100\n".into()),
            ("diskstats", String::new()),
            (
                "net/dev",
                "eth0: 100 0 0 0 0 0 0 0 100 0 0 0 0 0 0 0\n".into(),
            ),
            (
                "net/route",
                "Iface Destination Gateway Flags\neth0 00000000 00000000 0003\n".into(),
            ),
        ] {
            fs::write(proc.join(file), content).unwrap();
        }
    }
    fn write(path: &Path, content: &str) {
        fs::create_dir_all(path.parent().unwrap()).unwrap();
        fs::write(path, content).unwrap();
    }
    /// A collector that reads only the fake host and runs no external probe.
    fn collector(c: &Config, root: &Path) -> LocalCollector {
        let mut collector = LocalCollector::new(c);
        collector.proc = ProcReader::new(root.join("proc"), root.join("sys"));
        collector.energy = EnergyMeter::open(None, root.join("sys"), wall());
        for source in collector.sources.values_mut() {
            source.next_run = f64::INFINITY;
        }
        collector
    }
    fn quiet(local_type: &str) -> Config {
        Config {
            local_type: local_type.into(),
            node: "pve".into(),
            enable_gpus: false,
            enable_faults: false,
            enable_turbostat: false,
            ..Config::default()
        }
    }

    #[tokio::test]
    async fn host_without_thread_or_energy_sources_keeps_its_snapshot_shape() {
        let root = tempfile::tempdir().unwrap();
        fake_host(root.path());
        let c = quiet("server");
        let snapshot = collector(&c, root.path()).collect(&c, 1).await;
        assert!(snapshot.get("energy").is_none());
        assert!(snapshot["host"].get("cpu_core_kinds").is_none());
        for name in ["energy", "guest_configs"] {
            assert!(snapshot["sources"].get(name).is_none(), "{name}");
        }
        let keys = snapshot
            .as_object()
            .unwrap()
            .keys()
            .map(String::as_str)
            .collect::<BTreeSet<_>>();
        assert_eq!(
            keys,
            BTreeSet::from([
                "schema",
                "sequence",
                "generated_at",
                "host",
                "power",
                "guests",
                "storage",
                "disks",
                "sensors",
                "gpus",
                "alerts",
                "sources",
                "faults",
                "limits",
                "platform"
            ])
        );
    }

    #[tokio::test]
    async fn proxmox_snapshot_gains_thread_kinds_guest_pinning_and_energy() {
        let root = tempfile::tempdir().unwrap();
        fake_host(root.path());
        let sys = root.path().join("sys");
        write(&sys.join("devices/cpu_core/cpus"), "0-1\n");
        write(&sys.join("devices/cpu_atom/cpus"), "2-3\n");
        let zone = sys.join("class/powercap/intel-rapl:0");
        write(&zone.join("name"), "package-0\n");
        write(&zone.join("energy_uj"), "5000000\n");
        write(&zone.join("max_energy_range_uj"), "262143328850\n");
        let c = quiet("proxmox");
        let mut collector = collector(&c, root.path());
        let (now, mono) = (wall(), monotonic());
        let guests = json!([
            {"id":100,"name":"pinned","type":"vm","status":"running","mem_used_bytes":5,"mem_total_bytes":10},
            {"id":101,"name":"free","type":"vm","status":"running","mem_used_bytes":5,"mem_total_bytes":10},
            {"id":102,"name":"box","type":"lxc","status":"running","mem_used_bytes":5,"mem_total_bytes":10},
            {"id":103,"name":"unread","type":"vm","status":"stopped","mem_used_bytes":null,"mem_total_bytes":10}
        ]);
        let configs = json!({"configs":{
            "100":{"cpu_affinity":[2,3],"cpu_count":2},
            "101":{"cpu_affinity":null,"cpu_count":4},
            "102":{"cpu_affinity":null}
        },"error":null});
        for (name, data) in [
            (
                "proxmox",
                json!({"guests":guests,"storage":[],"node_error":null,"io_wait_pct":null}),
            ),
            ("guest_configs", configs),
        ] {
            collector
                .sources
                .get_mut(name)
                .unwrap()
                .commit((0, Ok(data)), mono, now);
        }
        let snapshot = collector.collect(&c, 1).await;
        assert_eq!(
            snapshot["host"]["cpu_core_kinds"],
            json!(["performance", "performance", "efficiency", "efficiency"])
        );
        let g = &snapshot["guests"];
        assert_eq!(g[0]["cpu_affinity"], json!([2, 3]));
        assert_eq!(g[0]["cpu_count"], 2);
        assert!(g[1]["cpu_affinity"].is_null());
        assert!(g[1].as_object().unwrap().contains_key("cpu_affinity"));
        assert_eq!(g[1]["cpu_count"], 4);
        assert!(g[2]["cpu_affinity"].is_null());
        assert!(g[2].get("cpu_count").is_none());
        assert!(
            g[3].get("cpu_affinity").is_none(),
            "a guest whose configuration was not read stays unknown"
        );
        assert_eq!(g[0]["mem_total_bytes"], 10, "existing fields are untouched");
        assert_eq!(
            *collector.guest_roster.lock().unwrap(),
            [
                (100, Kind::Qemu),
                (101, Kind::Qemu),
                (102, Kind::Lxc),
                (103, Kind::Qemu)
            ],
            "the configuration source is told which guests exist"
        );
        let energy = &snapshot["energy"];
        assert_eq!(energy["scope"], "components");
        assert_eq!(energy["persistent"], false);
        assert_eq!(energy["domains"][0]["id"], "cpu-package");
        assert_eq!(energy["domains"][0]["source"], "rapl");
        assert!(energy["since"].as_u64().unwrap() > 0);
        assert_eq!(snapshot["sources"]["energy"]["ok"], true);
        assert_eq!(snapshot["sources"]["guest_configs"]["ok"], true);
        assert!(serde_json::to_vec(&snapshot).unwrap().len() <= crate::MAX_PAYLOAD);
    }

    #[tokio::test]
    async fn a_failed_guest_configuration_read_never_blocks_the_snapshot() {
        let root = tempfile::tempdir().unwrap();
        fake_host(root.path());
        let c = quiet("proxmox");
        let mut collector = collector(&c, root.path());
        let (now, mono) = (wall(), monotonic());
        collector.sources.get_mut("proxmox").unwrap().commit(
            (
                0,
                Ok(json!({"guests":[{"id":100,"name":"a","type":"vm","status":"running"}],"storage":[],"node_error":null,"io_wait_pct":null})),
            ),
            mono,
            now,
        );
        collector.sources.get_mut("guest_configs").unwrap().commit(
            (0, Err(anyhow::anyhow!("pvesh timed out"))),
            mono,
            now,
        );
        let snapshot = collector.collect(&c, 1).await;
        assert_eq!(snapshot["guests"][0]["name"], "a");
        assert!(snapshot["guests"][0].get("cpu_affinity").is_none());
        assert_eq!(snapshot["sources"]["proxmox"]["ok"], true);
        assert_eq!(snapshot["sources"]["guest_configs"]["ok"], false);
    }

    #[test]
    fn a_replacement_collector_continues_the_running_energy_counter() {
        let root = tempfile::tempdir().unwrap();
        let zone = root.path().join("class/powercap/intel-rapl:0");
        write(&zone.join("name"), "package-0\n");
        write(&zone.join("energy_uj"), "1000\n");
        let c = Config::default();
        let mut old = LocalCollector::new(&c);
        old.energy = EnergyMeter::open(None, root.path(), 1000.);
        old.energy.observe(&EnergyInput::default(), 1000., 1.);
        let mut new = LocalCollector::new(&c);
        new.energy = EnergyMeter::open(None, root.path(), 9999.);
        new.take_energy_from(&mut old);
        assert_eq!(new.energy.snapshot().unwrap()["since"], 1000);
        assert!(old.energy.snapshot().is_none());
    }
}
