gkostadinov/glimdock/(commit log)

2026-10-08 Publish Glimdock v0.1.0 developer source and documentation
    [partitions.csv]
2026-10-09 Keep community guides and issue templates with the public source
    [package-public-release.py]
2026-10-13 Add portable agent operations API and display prototype
2026-10-13 Publish licensed Pebble enclosure CAD and honest print validation guides
2026-10-13 Normalize public text assets for reproducible Git source fingerprints
2026-10-13 Keep gesture expectations current and run Agents privacy checks in CI
2026-10-13 docs(reader): document private pairing storage and relay interface
2026-10-13 release: refresh matching chat firmware, emulator and setup material
2026-10-13 fix(navigation): logo returns home within the current workspace
2026-10-14 Show macOS pressure, compression and estimated CPU power on the display
2026-10-14 Separate NVMe temperature limits from HDD and SATA alerts
2026-10-17 Add Flipper Bluetooth status screen with instant node caching
    Send compact System, Alerts, Agents and Printer pages through an authenticated
    native BLE service. Cache up to eight node summaries on the Flipper so local
    node navigation stays immediate offline, coalesce the latest stable-ID target,
    and refresh complete details in the background without renewing stale samples.
    Include matching Flipper build/upload tools, strict USB diagnostics, protocol
    and cache regression checks, CI/public-export support, dependency notices,
    updated guides and regenerated production browser/native previews.
    Validation: V1 + Momentum mntm-012 pairing and saved-bond reconnect; six-node
    online/offline navigatio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
2026-10-21 Bound ESP32 HTTP reads and recover stalled Wi-Fi connections
2026-10-21 Fix Bluetooth scan cleanup and add BAT_PWR shutdown
    Serialize NimBLE scan lifecycle on the host queue after a captured heap-corruption panic. Add debounced long-press and Settings shutdown, with battery latch release and USB deep sleep/wake. Cover scan completion/cancellation ownership, startup-held buttons, release-before-sleep, and actual LVGL power controls.
2026-10-21 Use Power button wording throughout device controls
2026-10-21 Publish firmware 0.5.7 in the website installer
    Pin the verified device image and matching source archive, refresh release/setup copy and the production demo, and sync the existing public storefront source. Export only reviewed scheduler files with deployment account IDs removed.
2026-10-30 Publish current Portable r45 enclosure
    Add 23 current printable parts with editable STEP/BREP, a self-contained assembly viewer, and eight portable OrcaSlicer layouts. Update public enclosure documentation and license notices, with integrity and privacy checks for the curated files.
    Validated CAD and STL source bindings, all Orca import/export round trips, viewer modes and links, and the public source export. Machine profiles, printer connections, G-code and development history are excluded.
2026-10-30 Update public website for Portable r45 enclosure
2026-11-11 Report CPU thread kinds, guest CPU pinning and a persisted energy counter
    The Linux collector now adds three readings to its schema-1 snapshot, all
    additive and absent where a host cannot supply them.
    host.cpu_core_kinds: one entry per CPU row, "performance", "efficiency" or
    null, taken from the kernel's hybrid lists (/sys/devices/cpu_core/cpus and
    cpu_atom/cpus), parsed as CPU lists and matched by each row's CPU number.
    Never inferred from the model name; absent on non-hybrid hosts.
    Proxmox guests gain cpu_affinity (sorted host threads from the guest
    config's affinity option, null when unpinned, absent when unreadable) and
    cpu_count (vcpus, else cores x sockets, or cores for LXC). The con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
2026-11-11 Document thread kinds, guest pinning and the energy counter
    Describe the new snapshot fields, their absence rules and bounds, how the
    guest configurations are read and cached, how RAPL wrap and resets and the
    GPU gap rule are handled, and where the counter is kept.
